DominicChm/eCVT/..Miscellaneous/Finite State Machine Diagrams.pptx

TASK 1
eCVT RATIO

PRIMARY
ENCODER
TICKS

SECONDARY
ENCODER
TICKS

TASK 2
PRIMARY CLUTCH

TASK 3
SECONDARY CLUTCH

## Slide 2

TASK 1
eCVT RATIO

PRIMARY
ENCODER
TICKS

SECONDARY
ENCODER
TICKS

TASK 2
PRIMARY CLUTCH

TASK 3
SECONDARY CLUTCH

TUNE DATA

TASK 4
Xbee Communication

STATS DATA

## Slide 3

ENGINE SPEED < 3000
-- OR -- eRUN IS FALSE

STATE 0
INITIALIZE

ALWAYS

ALWAYS /
eCAL IS FALSE

STATE 1
DISENGAGED

STATE 3
PID CONTROLLER
- UPDATE

STATE 2
PID CONTROLLER
- REST

ENGINE SPEED > 3000
-- AND -- eRUN IS TRUE

eCAL IS TRUE

## Slide 4

ALWAYS

STATE 0
INITIALIZE

STATE 1
CALIBRATING

ALWAYS /
pCAL IS FALSE

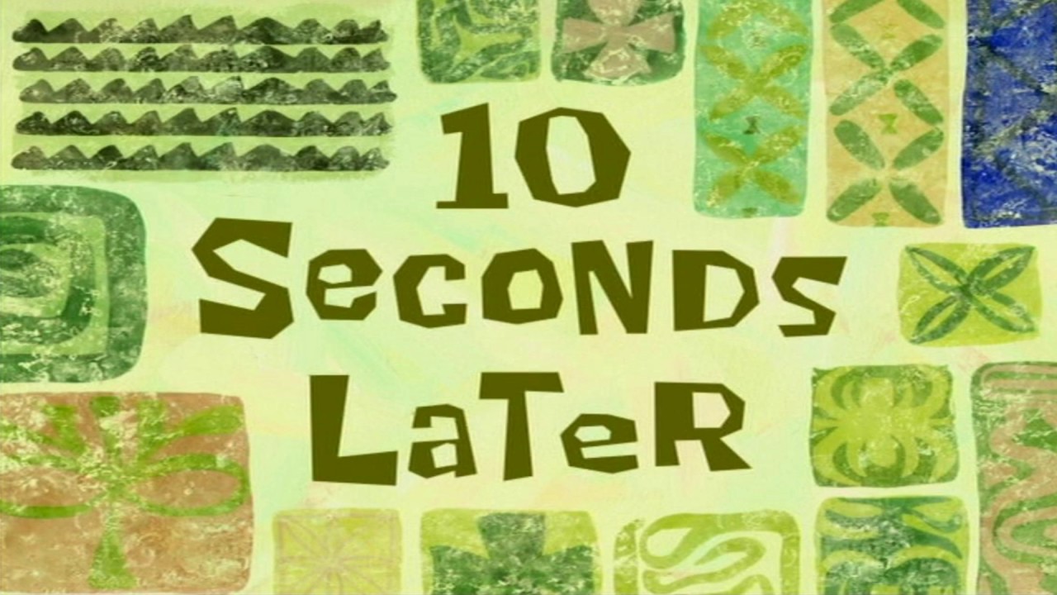
[picture p1: figure]

STATE 4
PID CONTROLLER
- UPDATE

STATE 2
CALIBRATED

STATE 3
PID CONTROLLER
- REST

pCAL IS TRUE

ALWAYS

## Slide 5

ALWAYS

STATE 0
INITIALIZE

STATE 1
CALIBRATING

ALWAYS /
sCAL IS FALSE

STATE 4
PID CONTROLLER
- UPDATE

STATE 2
CALIBRATED

STATE 3
PID CONTROLLER
- REST

sCAL IS TRUE

ALWAYS
