DominicChm/eCVT/..Miscellaneous/Simulation/PID Simulation/PID.pdf

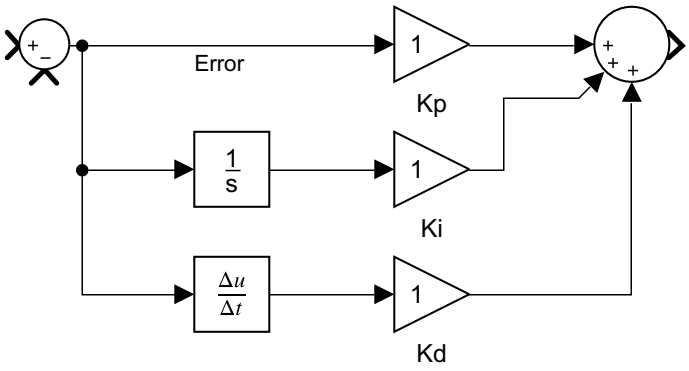
[picture p2: figure]
