DominicChm/eCVT/..Miscellaneous/Simulation/Lookup Table Simulation/CVT Ratio Lookup Table.png

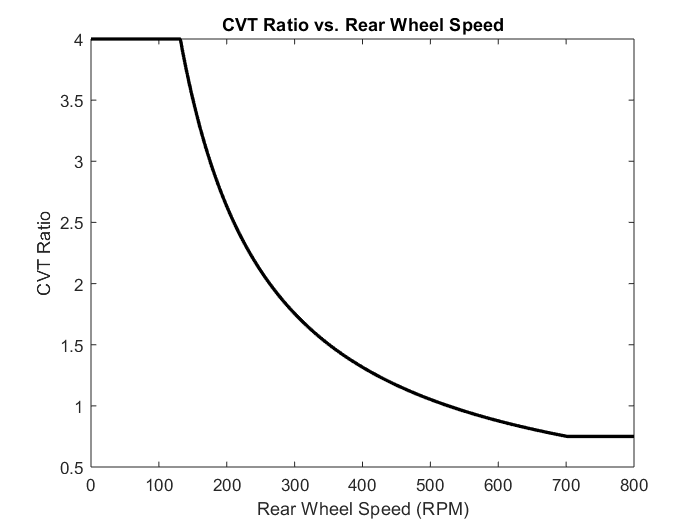
..Miscellaneous/Simulation/Lookup Table Simulation/CVT Ratio Lookup Table.png
