DominicChm/eCVT/..Miscellaneous/Simulation/PID Simulation/06-04-2019 PDR/Kp=0.002_Ki=0.010.png

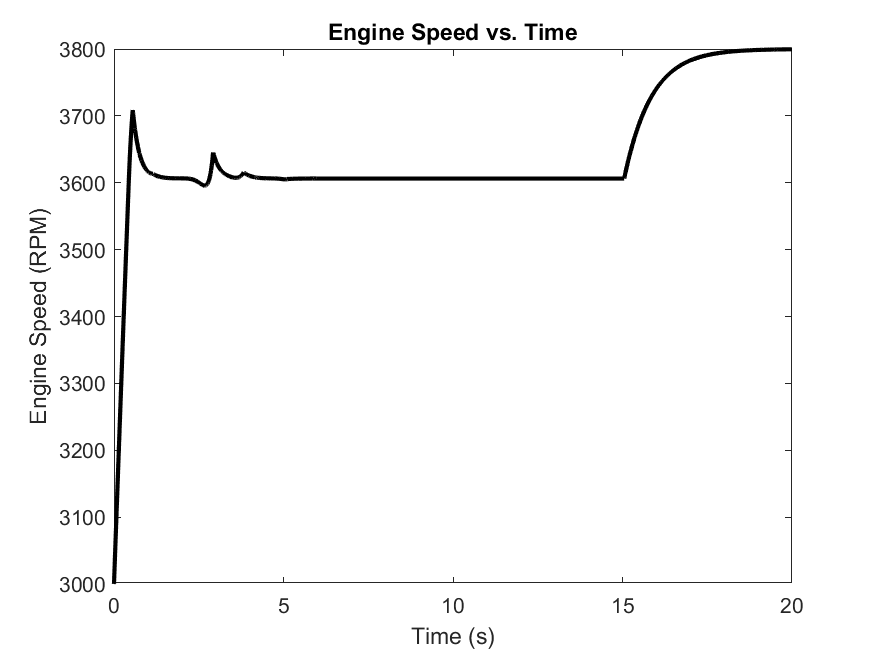
..Miscellaneous/Simulation/PID Simulation/06-04-2019 PDR/Kp=0.002_Ki=0.010.png
