DominicChm/eCVT/..Miscellaneous/Simulation/PID Simulation/06-04-2019 PDR/Kp=0.004_Ki=0.007.png

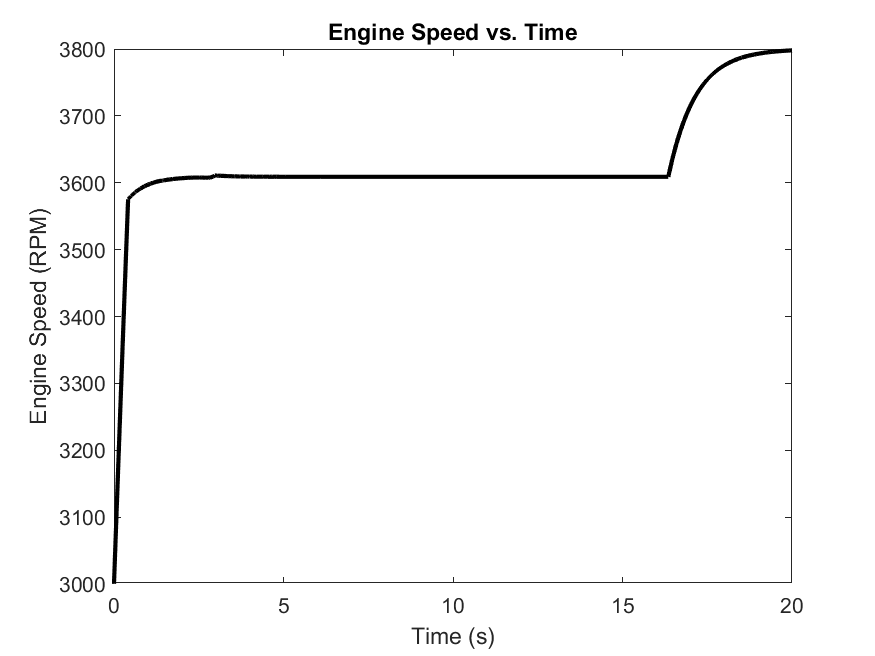
..Miscellaneous/Simulation/PID Simulation/06-04-2019 PDR/Kp=0.004_Ki=0.007.png
