DominicChm/eCVT/..Miscellaneous/Simulation/PID Simulation/EngineControl_PID_Complex.PNG

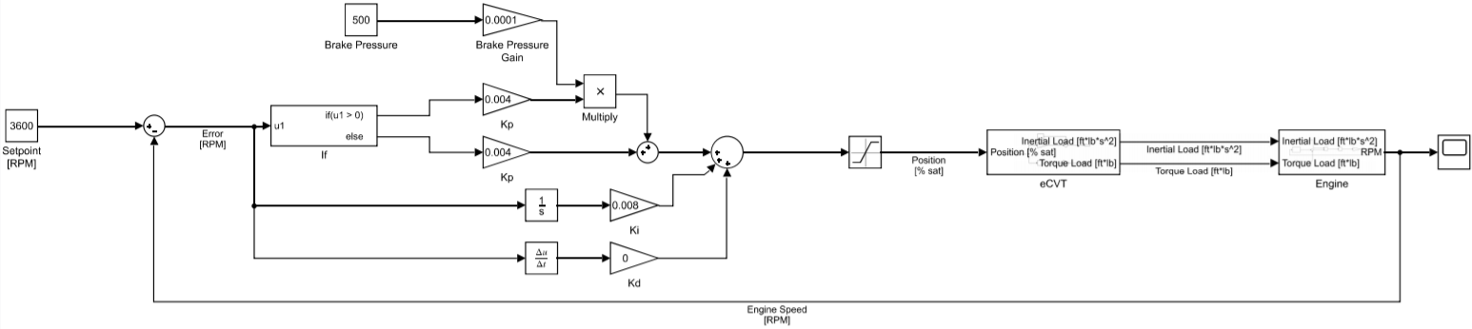
..Miscellaneous/Simulation/PID Simulation/EngineControl_PID_Complex.PNG
