DominicChm/eCVT/..Miscellaneous/Simulation/PID Simulation/EngineControl_PID_Complex_With_Sheaves.PNG

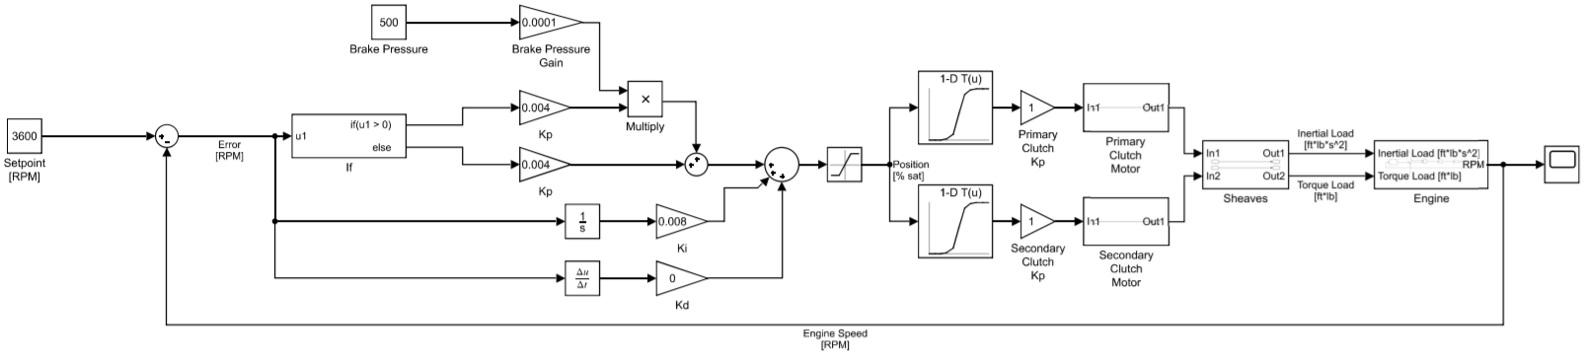
..Miscellaneous/Simulation/PID Simulation/EngineControl_PID_Complex_With_Sheaves.PNG
