DominicChm/eCVT/..Miscellaneous/Overview/ClutchControl_Overview.pdf

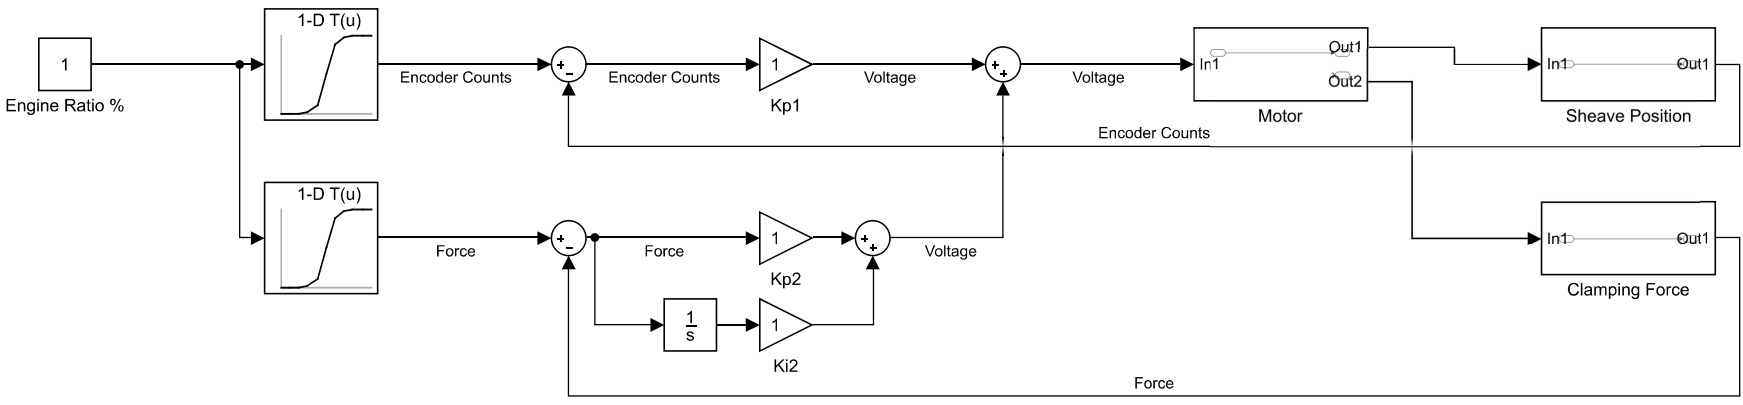
[picture p8: page 1]
