DominicChm/eCVT/..Miscellaneous/Simulation/PID Simulation/EngineControl_PID_Complex_With_Sheaves.pdf

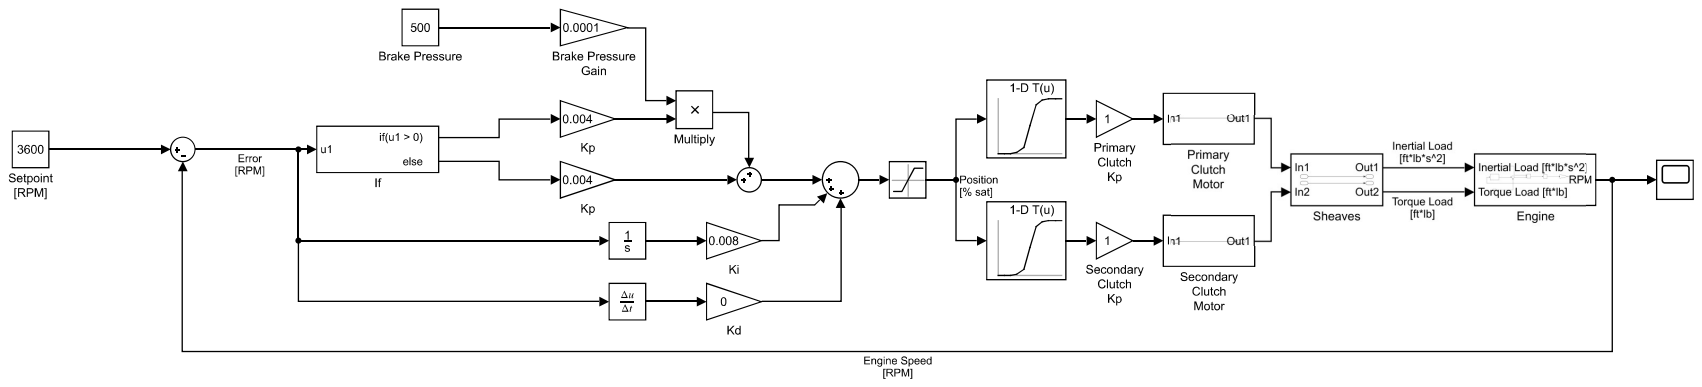
[picture p13: page 1]
