DominicChm/eCVT/..Miscellaneous/Simulation/PID Simulation/EngineControl_PID_Complex.pdf

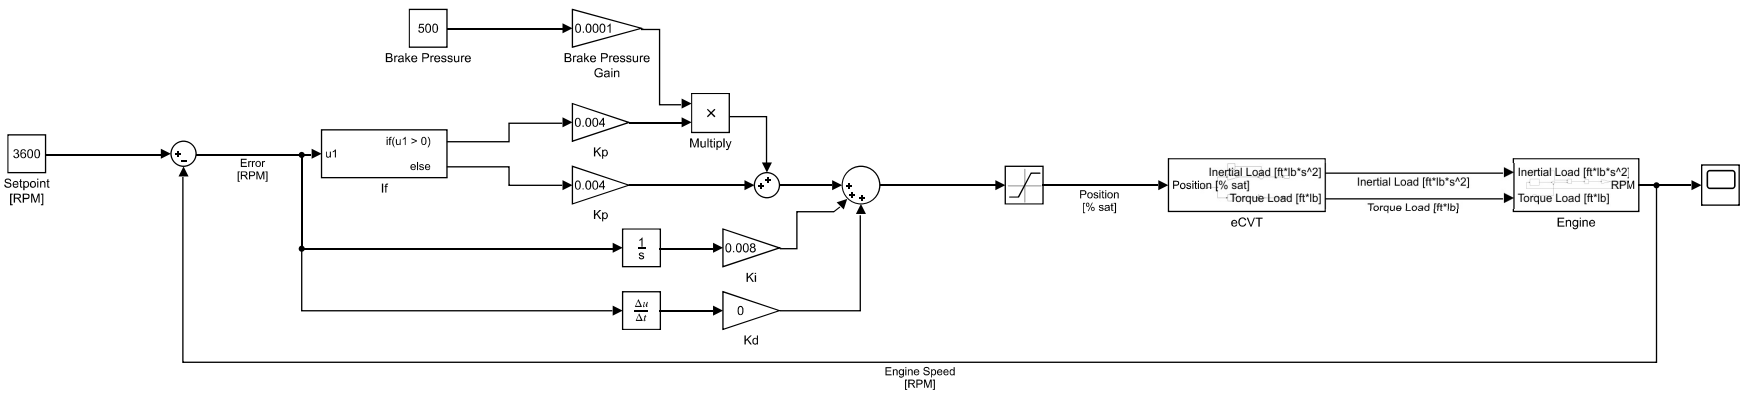
[picture p14: page 1]
