DominicChm/eCVT/..Miscellaneous/Hardware/March 2020 Edition/EAGLE/projects/DAQ and eCVT/DAQ and eCVT.brd

## EAGLE design ..Miscellaneous/Hardware/March 2020 Edition/EAGLE/projects/DAQ and eCVT/DAQ and eCVT.brd (2020-03-10)

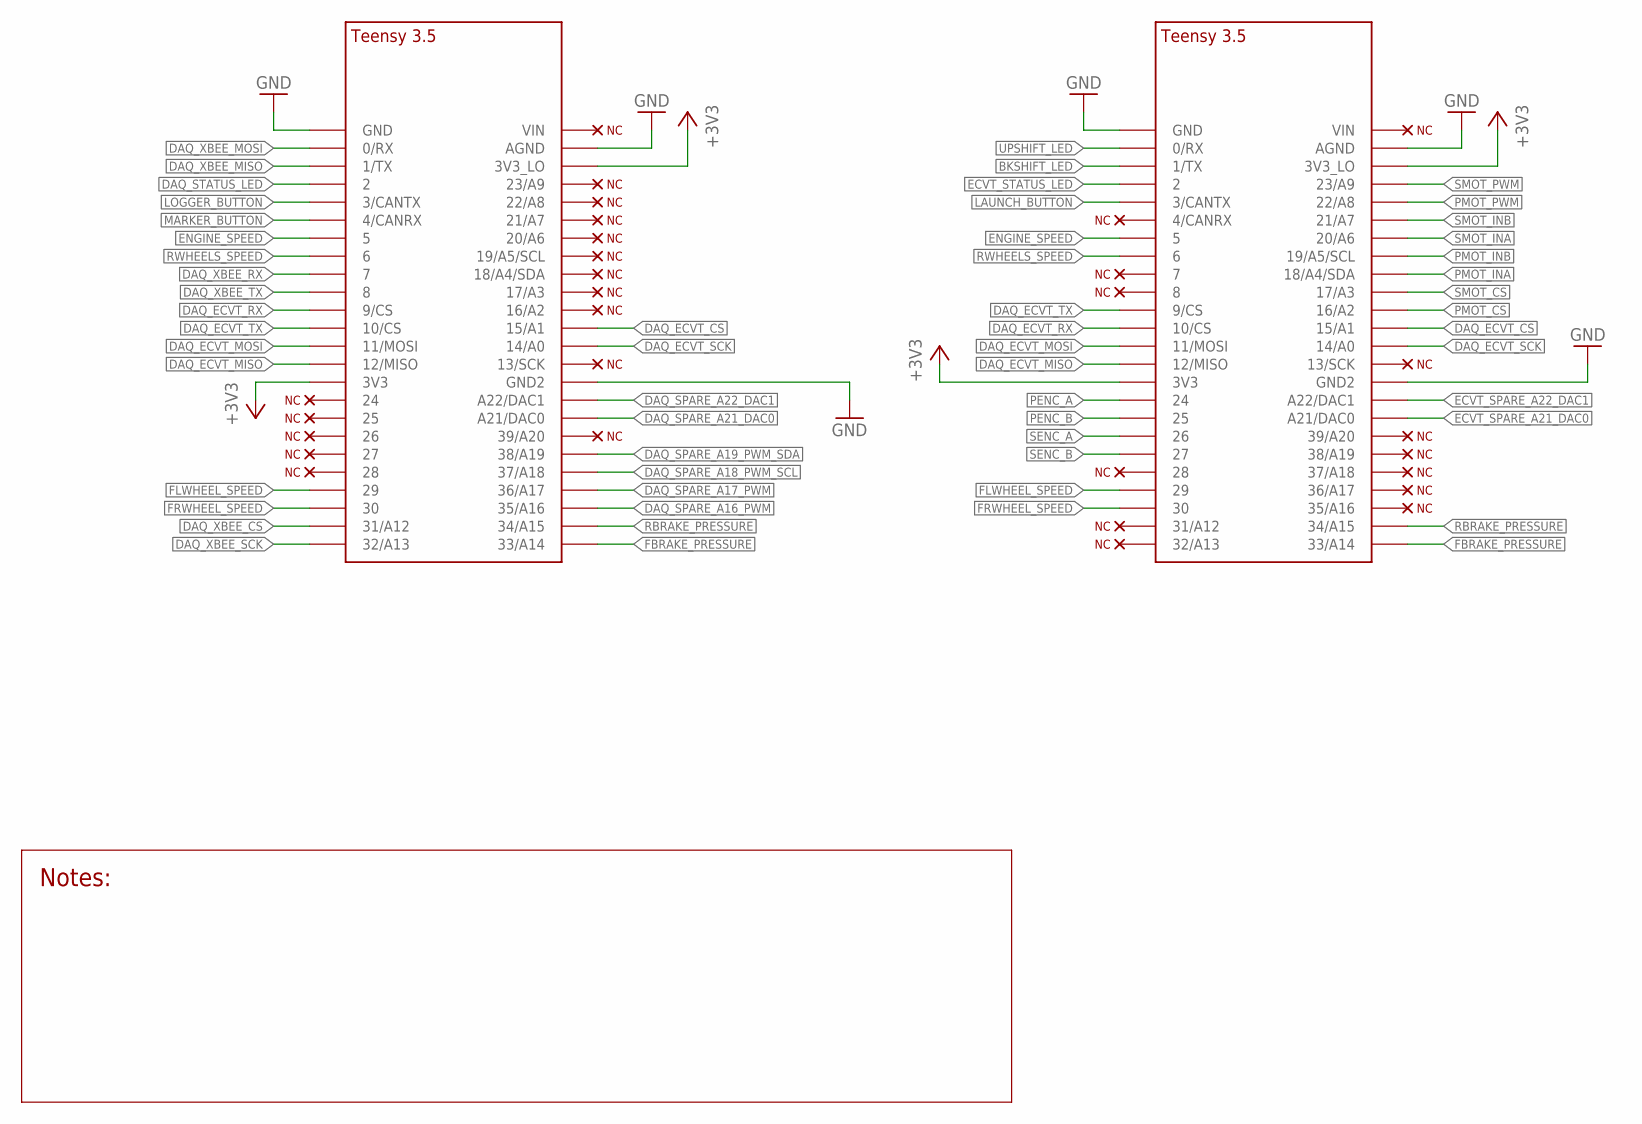
[picture p15: schematic DAQ and eCVT.sch, sheet 1]

Parts:
U$31, U$33: TEENSY_3.5_BAJA

Connections:
+3V3: U$31.3V3, U$31.3V3_LO, U$33.3V3, U$33.3V3_LO; also elsewhere on the board
BKSHIFT_LED: U$33.1/TX; also elsewhere on the board
DAQ_ECVT_CS: U$31.15/A1, U$33.15/A1
DAQ_ECVT_MISO: U$31.12/MISO, U$33.12/MISO
DAQ_ECVT_MOSI: U$31.11/MOSI, U$33.11/MOSI
DAQ_ECVT_RX: U$31.9/CS, U$33.10/CS
DAQ_ECVT_SCK: U$31.14/A0, U$33.14/A0
DAQ_ECVT_TX: U$31.10/CS, U$33.9/CS
DAQ_SPARE_A16_PWM: U$31.35/A16; also elsewhere on the board
DAQ_SPARE_A17_PWM: U$31.36/A17; also elsewhere on the board
DAQ_SPARE_A18_PWM_SCL: U$31.37/A18; also elsewhere on the board
DAQ_SPARE_A19_PWM_SDA: U$31.38/A19; also elsewhere on the board
DAQ_SPARE_A21_DAC0: U$31.21/DAC0 (A21/DAC0); also elsewhere on the board
DAQ_SPARE_A22_DAC1: U$31.A22/DAC1; also elsewhere on the board
DAQ_STATUS_LED: U$31.2; also elsewhere on the board
DAQ_XBEE_CS: U$31.31/A12; also elsewhere on the board
DAQ_XBEE_MISO: U$31.1/TX; also elsewhere on the board
DAQ_XBEE_MOSI: U$31.0/RX; also elsewhere on the board
DAQ_XBEE_RX: U$31.7; also elsewhere on the board
DAQ_XBEE_SCK: U$31.32/A13; also elsewhere on the board
DAQ_XBEE_TX: U$31.8; also elsewhere on the board
ECVT_SPARE_A21_DAC0: U$33.21/DAC0 (A21/DAC0); also elsewhere on the board
ECVT_SPARE_A22_DAC1: U$33.A22/DAC1; also elsewhere on the board
ECVT_STATUS_LED: U$33.2; also elsewhere on the board
ENGINE_SPEED: U$31.5, U$33.5; also elsewhere on the board
FBRAKE_PRESSURE: U$31.33/A14, U$33.33/A14; also elsewhere on the board
FLWHEEL_SPEED: U$31.29, U$33.29; also elsewhere on the board
FRWHEEL_SPEED: U$31.30, U$33.30; also elsewhere on the board
GND: U$31.AGND, U$31.GND, U$31.GND2, U$33.AGND, U$33.GND, U$33.GND2; also elsewhere on the board
LAUNCH_BUTTON: U$33.3/CANTX; also elsewhere on the board
LOGGER_BUTTON: U$31.3/CANTX; also elsewhere on the board
MARKER_BUTTON: U$31.4/CANRX; also elsewhere on the board
PENC_A: U$33.24; also elsewhere on the board
PENC_B: U$33.25; also elsewhere on the board
PMOT_CS: U$33.16/A2; also elsewhere on the board
PMOT_INA: U$33.18/A4/SDA; also elsewhere on the board
PMOT_INB: U$33.19/A5/SCL; also elsewhere on the board
PMOT_PWM: U$33.22/A8; also elsewhere on the board
RBRAKE_PRESSURE: U$31.34/A15, U$33.34/A15; also elsewhere on the board
RWHEELS_SPEED: U$31.6, U$33.6; also elsewhere on the board
SENC_A: U$33.26; also elsewhere on the board
SENC_B: U$33.27; also elsewhere on the board
SMOT_CS: U$33.17/A3; also elsewhere on the board
SMOT_INA: U$33.20/A6; also elsewhere on the board
SMOT_INB: U$33.21/A7; also elsewhere on the board
SMOT_PWM: U$33.23/A9; also elsewhere on the board
UPSHIFT_LED: U$33.0/RX; also elsewhere on the board

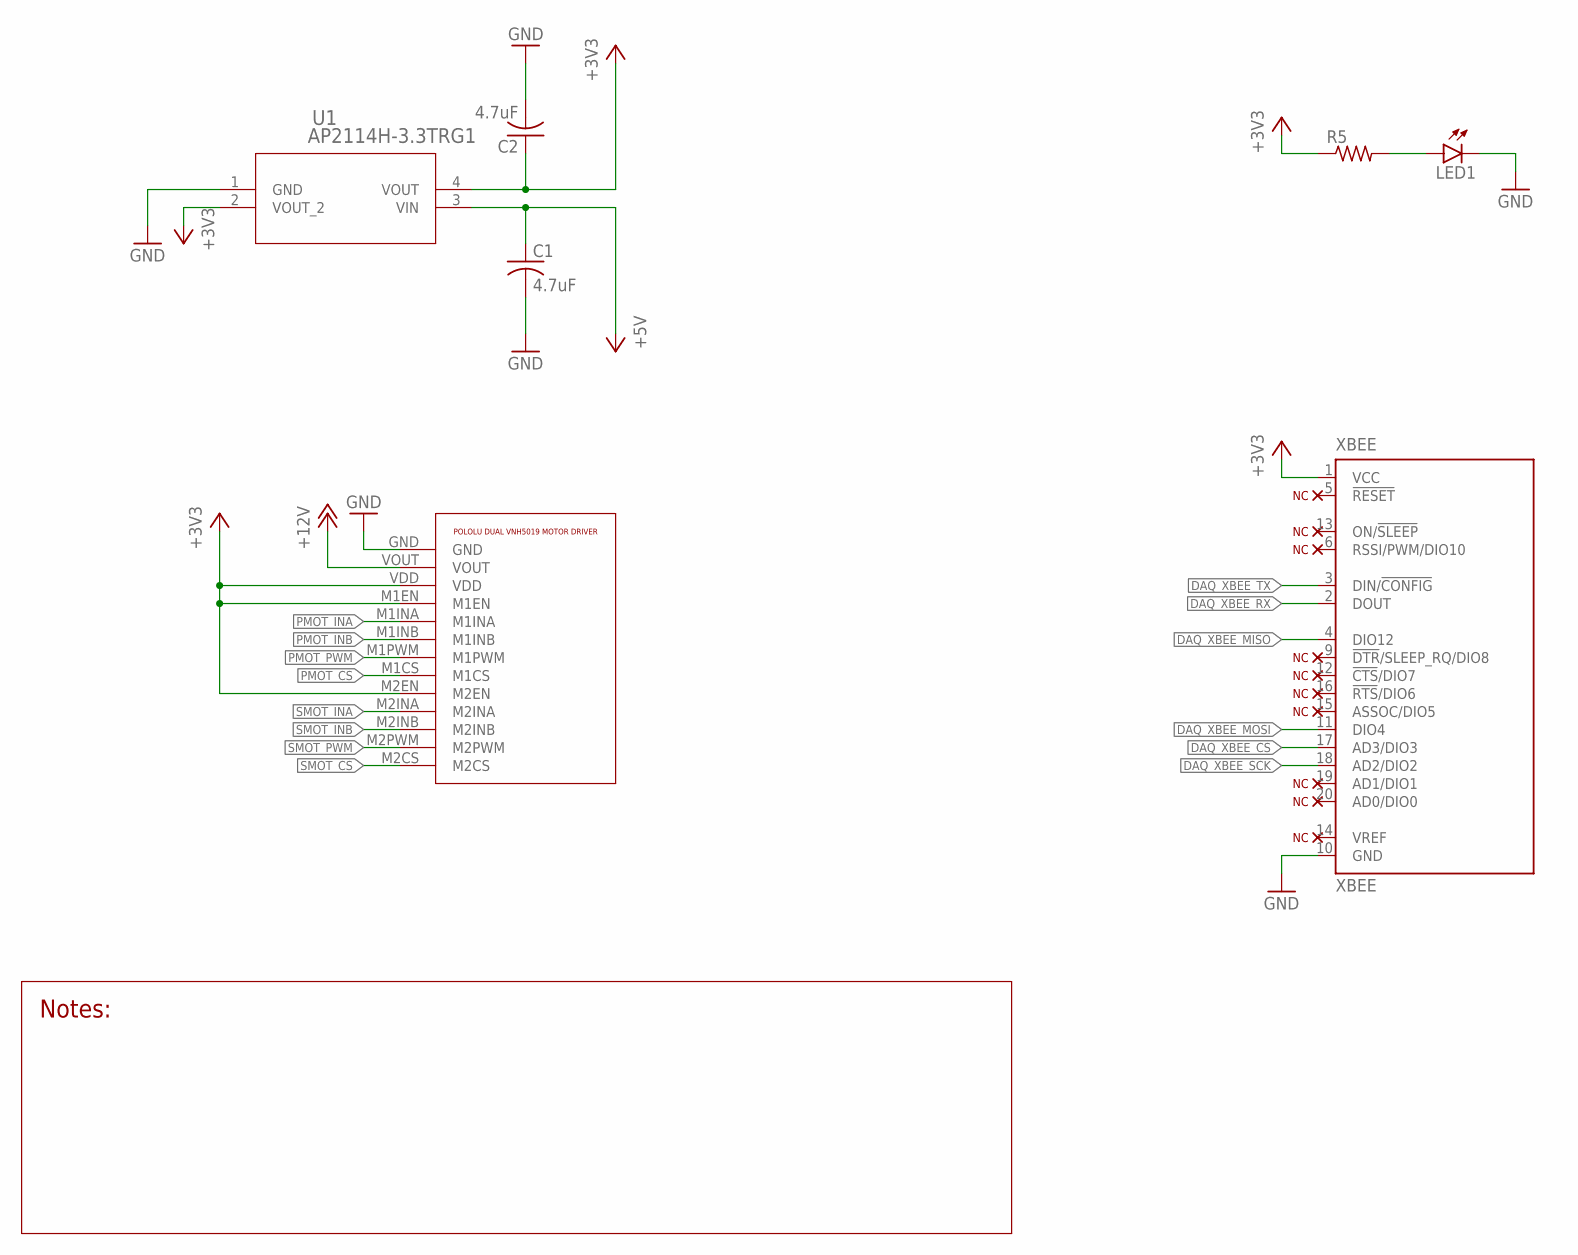
[picture p16: schematic DAQ and eCVT.sch, sheet 2]

Parts:
C1, C2: 4.7uF; C0805
LED1: LEDCHIPLED_0805; CHIPLED_0805
R5: R-US_R0805; R0805
U1: AP2114H-3.3TRG1; SOT-223
U$28: POLOLU_DUAL_VNH5019_BAJA
XBEE: XBEE

Connections:
+3V3: C2.1, R5.1, U1.2 (VOUT_2), U1.4 (VOUT), U$28.M1EN, U$28.M2EN, U$28.VDD, XBEE.1 (VCC); also elsewhere on the board
+5V: C1.1, U1.3 (VIN); also elsewhere on the board
+12V: U$28.VOUT; also elsewhere on the board
DAQ_XBEE_CS: XBEE.17 (AD3/DIO3); also elsewhere on the board
DAQ_XBEE_MISO: XBEE.4 (DIO12); also elsewhere on the board
DAQ_XBEE_MOSI: XBEE.11 (DIO4); also elsewhere on the board
DAQ_XBEE_RX: XBEE.2 (DOUT); also elsewhere on the board
DAQ_XBEE_SCK: XBEE.18 (AD2/DIO2); also elsewhere on the board
DAQ_XBEE_TX: XBEE.3 (DIN/!CONFIG); also elsewhere on the board
GND: C1.2, C2.2, LED1.C, U1.1 (GND), U$28.GND, XBEE.10 (GND); also elsewhere on the board
LED: LED1.A, R5.2
PMOT_CS: U$28.M1CS; also elsewhere on the board
PMOT_INA: U$28.M1INA; also elsewhere on the board
PMOT_INB: U$28.M1INB; also elsewhere on the board
PMOT_PWM: U$28.M1PWM; also elsewhere on the board
SMOT_CS: U$28.M2CS; also elsewhere on the board
SMOT_INA: U$28.M2INA; also elsewhere on the board
SMOT_INB: U$28.M2INB; also elsewhere on the board
SMOT_PWM: U$28.M2PWM; also elsewhere on the board

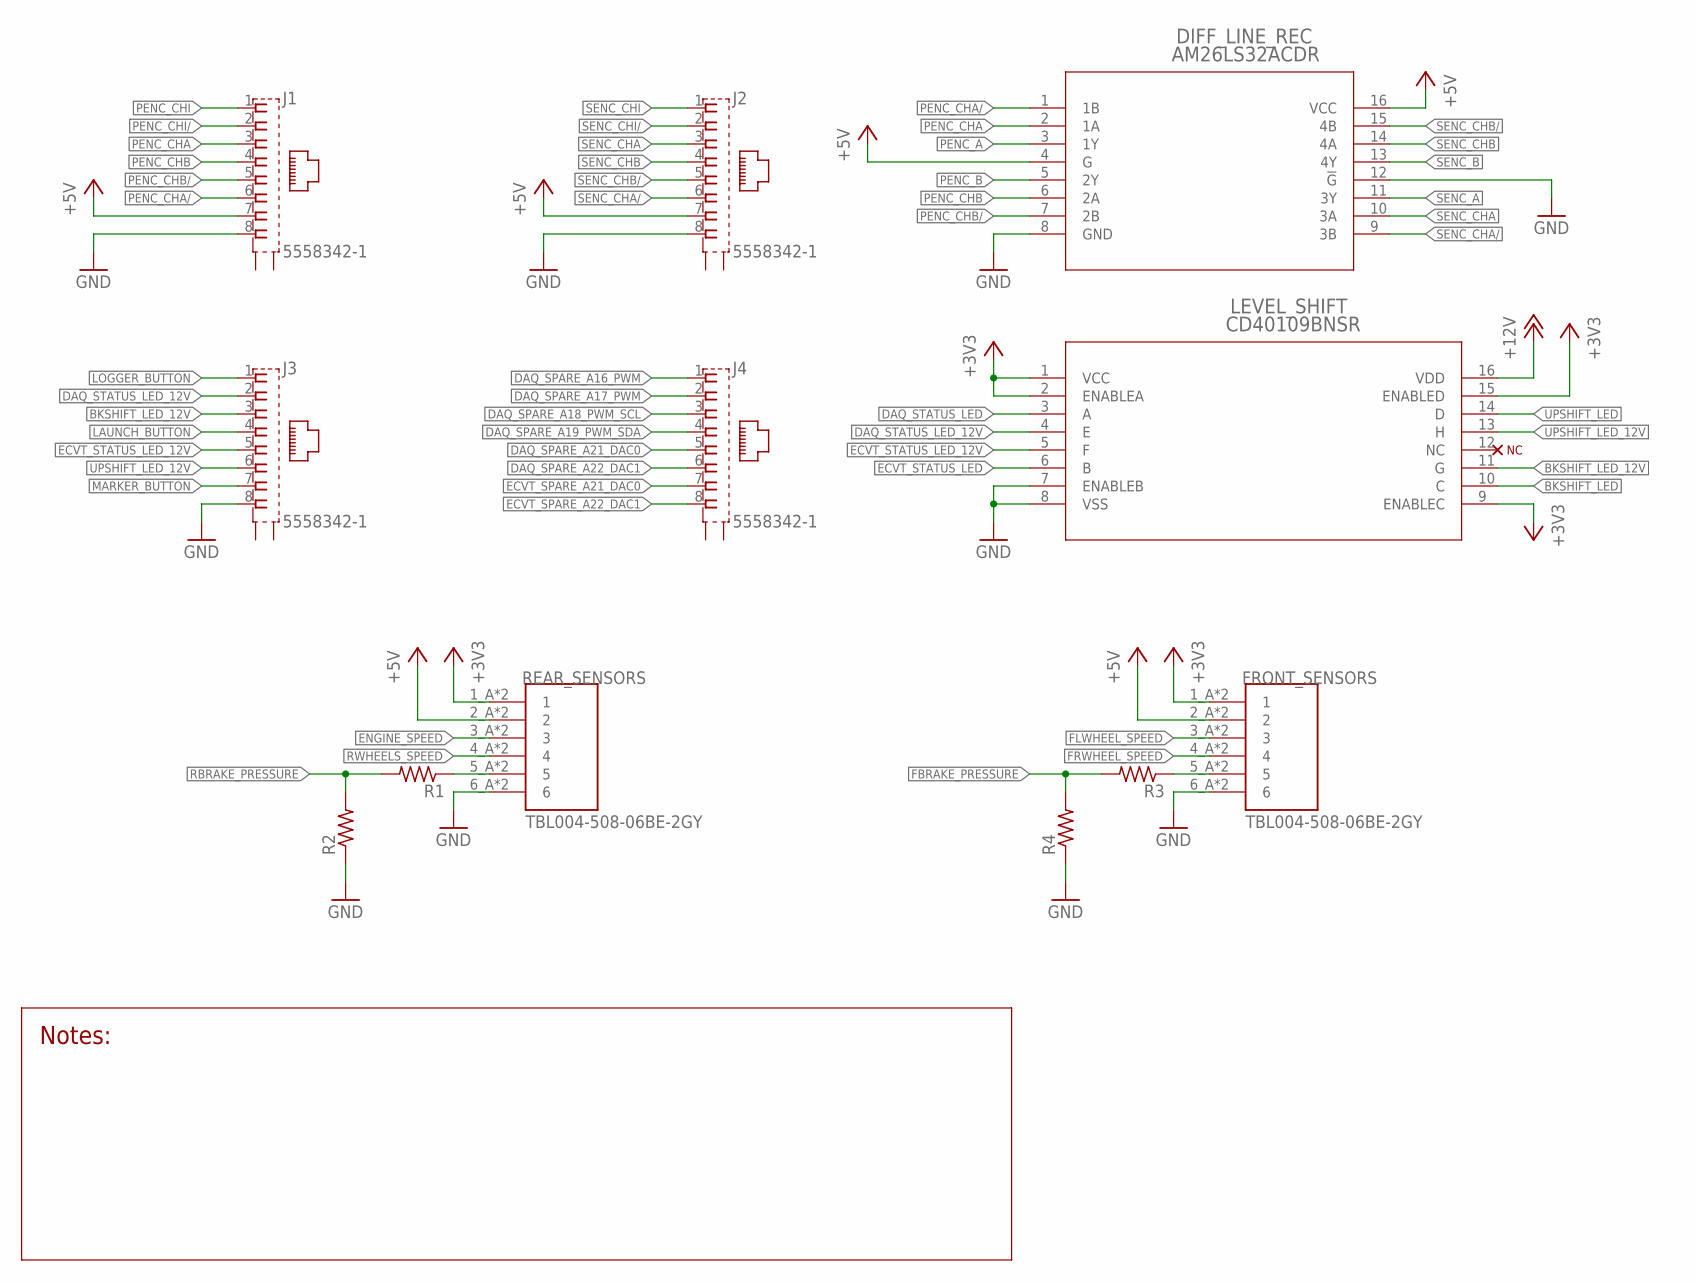
[picture p17: schematic DAQ and eCVT.sch, sheet 3]

Parts:
DIFF_LINE_REC: AM26LS32ACDR; D16
FRONT_SENSORS: TBL004-508-06BE-2GY; CUI_TBL004-508-06BE-2GY
J1, J2, J3, J4: 5558342-1; TE_5558342-1
LEVEL_SHIFT: CD40109BNSR; NS16
R1, R2, R3, R4: R-US_0204/7; 0204/7
REAR_SENSORS: TBL004-508-06BE-2GY; CUI_TBL004-508-06BE-2GY

Connections:
+3V3: FRONT_SENSORS.1_A (1), FRONT_SENSORS.1_B (1), LEVEL_SHIFT.1 (VCC), LEVEL_SHIFT.2 (ENABLEA), LEVEL_SHIFT.9 (ENABLEC), LEVEL_SHIFT.15 (ENABLED), REAR_SENSORS.1_A (1), REAR_SENSORS.1_B (1); also elsewhere on the board
+5V: DIFF_LINE_REC.4 (G), DIFF_LINE_REC.16 (VCC), FRONT_SENSORS.2_A (2), FRONT_SENSORS.2_B (2), J1.7, J2.7, REAR_SENSORS.2_A (2), REAR_SENSORS.2_B (2); also elsewhere on the board
+12V: LEVEL_SHIFT.16 (VDD); also elsewhere on the board
BKSHIFT_LED: LEVEL_SHIFT.10 (C); also elsewhere on the board
BKSHIFT_LED_12V: J3.3, LEVEL_SHIFT.11 (G)
DAQ_SPARE_A16_PWM: J4.1; also elsewhere on the board
DAQ_SPARE_A17_PWM: J4.2; also elsewhere on the board
DAQ_SPARE_A18_PWM_SCL: J4.3; also elsewhere on the board
DAQ_SPARE_A19_PWM_SDA: J4.4; also elsewhere on the board
DAQ_SPARE_A21_DAC0: J4.5; also elsewhere on the board
DAQ_SPARE_A22_DAC1: J4.6; also elsewhere on the board
DAQ_STATUS_LED: LEVEL_SHIFT.3 (A); also elsewhere on the board
DAQ_STATUS_LED_12V: J3.2, LEVEL_SHIFT.4 (E)
ECVT_SPARE_A21_DAC0: J4.7; also elsewhere on the board
ECVT_SPARE_A22_DAC1: J4.8; also elsewhere on the board
ECVT_STATUS_LED: LEVEL_SHIFT.6 (B); also elsewhere on the board
ECVT_STATUS_LED_12V: J3.5, LEVEL_SHIFT.5 (F)
ENGINE_SPEED: REAR_SENSORS.3_A (3), REAR_SENSORS.3_B (3); also elsewhere on the board
FBRAKE_PRESSURE: R3.2, R4.2; also elsewhere on the board
FBRAKE_PRESSURE_BEFORE_RESISTORS: FRONT_SENSORS.5_A (5), FRONT_SENSORS.5_B (5), R3.1
FLWHEEL_SPEED: FRONT_SENSORS.3_A (3), FRONT_SENSORS.3_B (3); also elsewhere on the board
FRWHEEL_SPEED: FRONT_SENSORS.4_A (4), FRONT_SENSORS.4_B (4); also elsewhere on the board
GND: DIFF_LINE_REC.8 (GND), DIFF_LINE_REC.12 (!G), FRONT_SENSORS.6_A (6), FRONT_SENSORS.6_B (6), J1.8, J2.8, J3.8, LEVEL_SHIFT.7 (ENABLEB), LEVEL_SHIFT.8 (VSS), R2.1, R4.1, REAR_SENSORS.6_A (6), REAR_SENSORS.6_B (6); also elsewhere on the board
LAUNCH_BUTTON: J3.4; also elsewhere on the board
LOGGER_BUTTON: J3.1; also elsewhere on the board
MARKER_BUTTON: J3.7; also elsewhere on the board
PENC_A: DIFF_LINE_REC.3 (1Y); also elsewhere on the board
PENC_B: DIFF_LINE_REC.5 (2Y); also elsewhere on the board
PENC_CHA: DIFF_LINE_REC.2 (1A), J1.3
PENC_CHA/: DIFF_LINE_REC.1 (1B), J1.6
PENC_CHB: DIFF_LINE_REC.6 (2A), J1.4
PENC_CHB/: DIFF_LINE_REC.7 (2B), J1.5
PENC_CHI: J1.1
PENC_CHI/: J1.2
RBRAKE_PRESSURE: R1.2, R2.2; also elsewhere on the board
RBRAKE_PRESSURE_BEFORE_RESISTORS: R1.1, REAR_SENSORS.5_A (5), REAR_SENSORS.5_B (5)
RWHEELS_SPEED: REAR_SENSORS.4_A (4), REAR_SENSORS.4_B (4); also elsewhere on the board
SENC_A: DIFF_LINE_REC.11 (3Y); also elsewhere on the board
SENC_B: DIFF_LINE_REC.13 (4Y); also elsewhere on the board
SENC_CHA: DIFF_LINE_REC.10 (3A), J2.3
SENC_CHA/: DIFF_LINE_REC.9 (3B), J2.6
SENC_CHB: DIFF_LINE_REC.14 (4A), J2.4
SENC_CHB/: DIFF_LINE_REC.15 (4B), J2.5
SENC_CHI: J2.1
SENC_CHI/: J2.2
UPSHIFT_LED: LEVEL_SHIFT.14 (D); also elsewhere on the board
UPSHIFT_LED_12V: J3.6, LEVEL_SHIFT.13 (H)

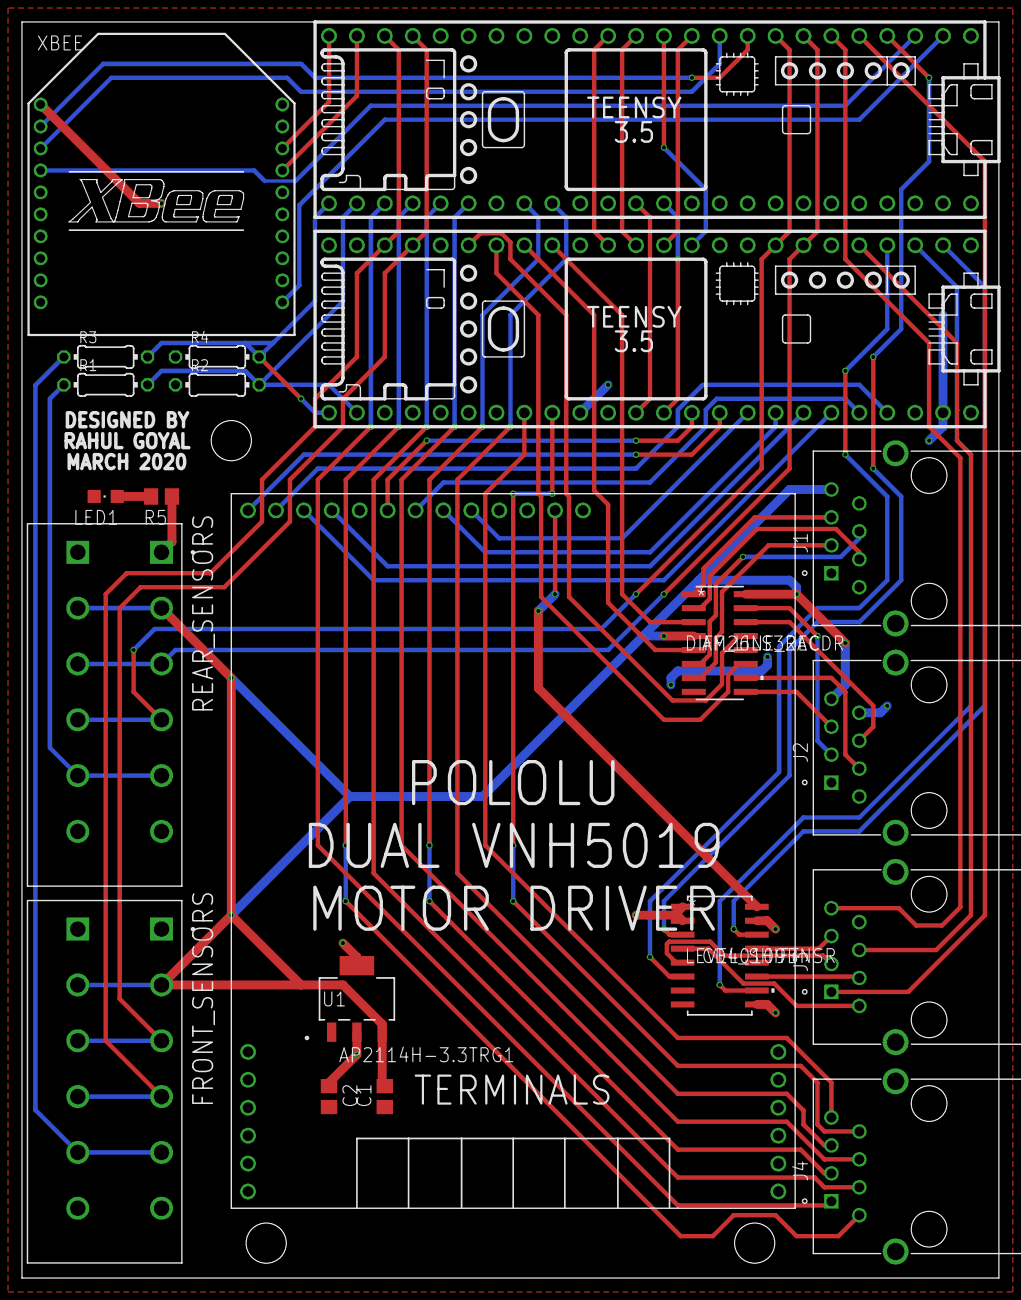
[picture p18: board ..Miscellaneous/Hardware/March 2020 Edition/EAGLE/projects/DAQ and eC… from above]

Board: 2 copper layers, 88.9 x 114.3 mm, 21 parts (0 on the bottom side), 64 nets.
