DominicChm/eCVT/..Miscellaneous/Hardware/ME 507/EAGLE/projects/eCVT 507/eCVT 507.brd

## EAGLE design ..Miscellaneous/Hardware/ME 507/EAGLE/projects/eCVT 507/eCVT 507.brd (2019-12-09)

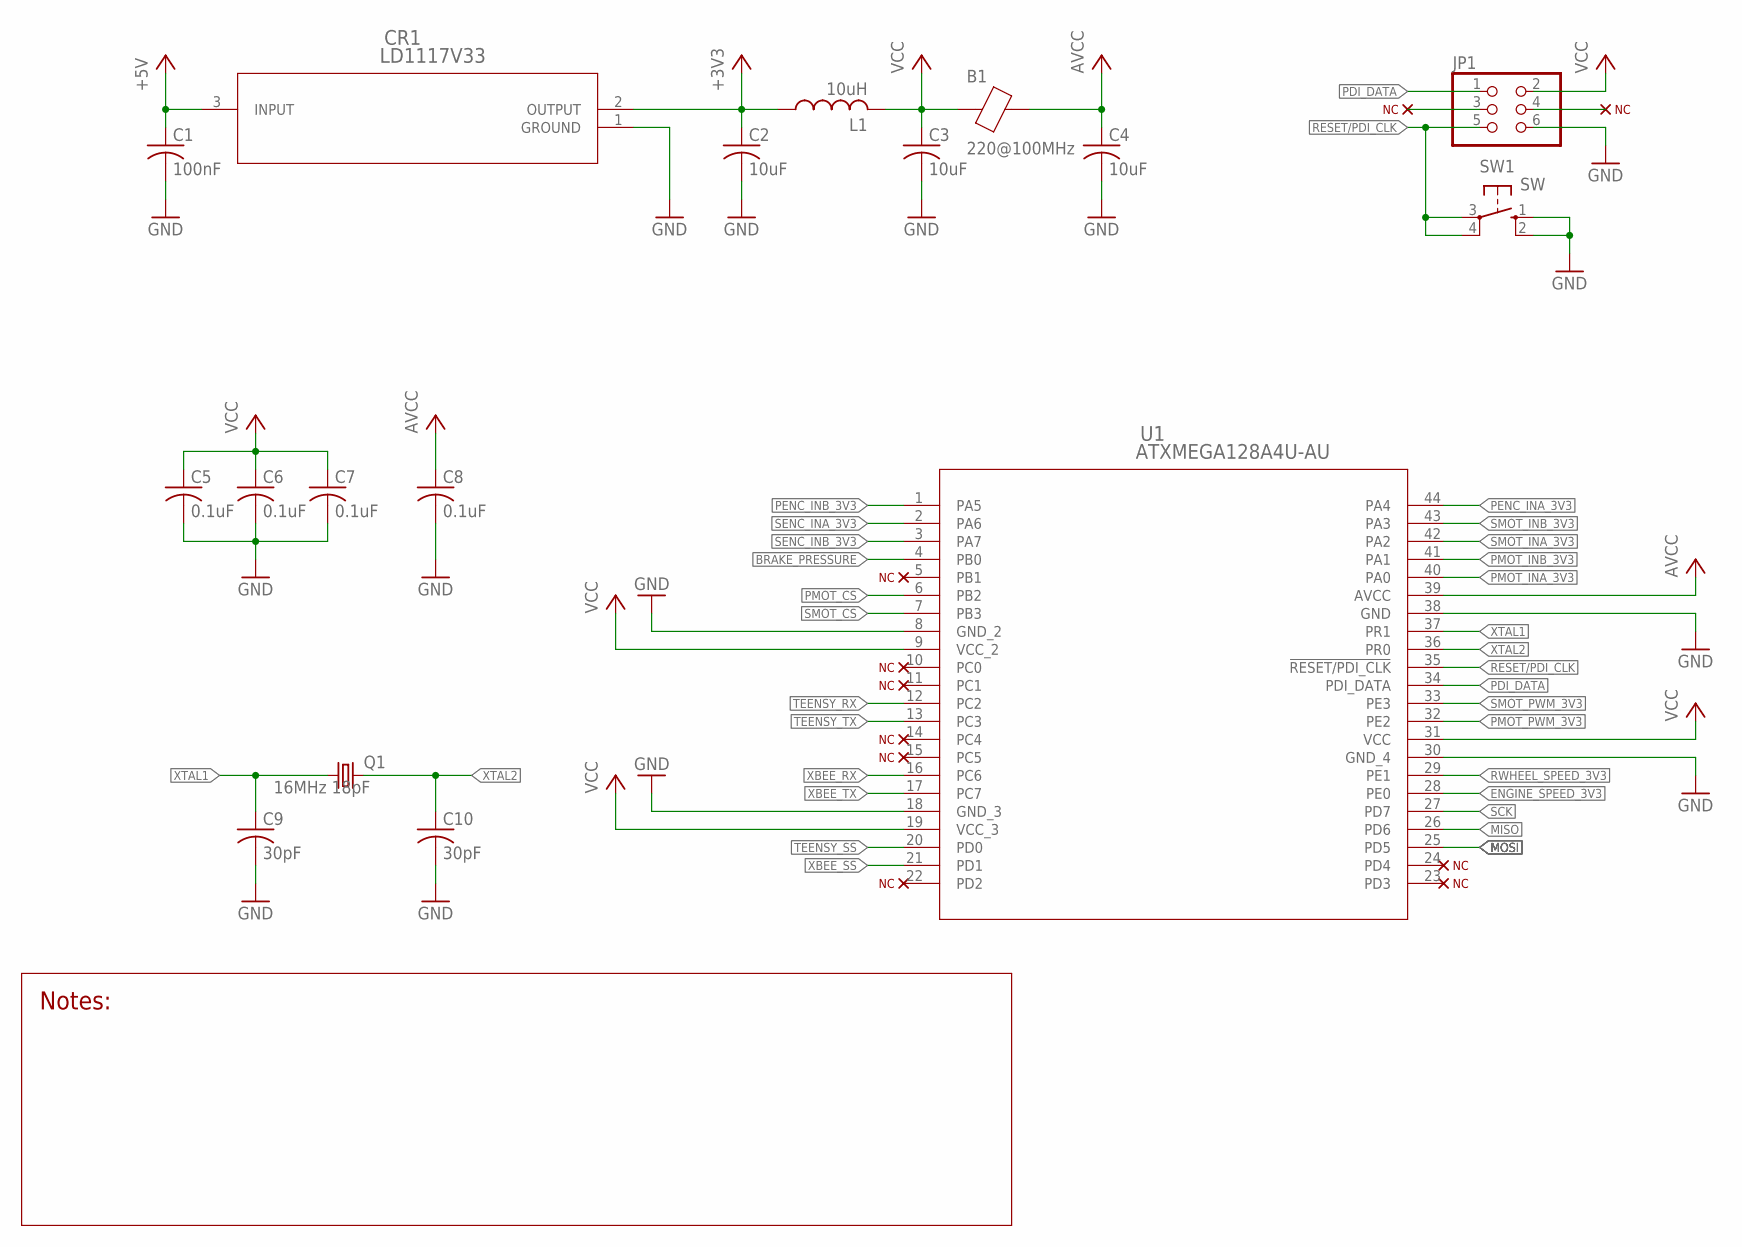
[picture p19: schematic eCVT 507.sch, sheet 1]

Parts:
B1: 220@100MHz; 0805
C1: 100nF; C0805
C2, C3, C4: 10uF; C0805
C5, C6, C7, C8: 0.1uF; C0805
C9, C10: 30pF; C0805
CR1: LD1117V33; TO-220
JP1: PINHD-2X3; 2X03
L1: 10uH; 0805
Q1: 16MHz 18pF; HC49/S
SW1: SW; B3F-10XX
U1: ATXMEGA128A4U-AU; 44A

Connections:
+3V3: C2.1, CR1.2 (OUTPUT), L1.1; also elsewhere on the board
+5V: C1.1, CR1.3 (INPUT); also elsewhere on the board
AVCC: B1.2, C4.1, C8.1, U1.39 (AVCC)
BRAKE_PRESSURE: U1.4 (PB0); also elsewhere on the board
ENGINE_SPEED_3V3: U1.28 (PE0); also elsewhere on the board
GND: C1.2, C2.2, C3.2, C4.2, C5.2, C6.2, C7.2, C8.2, C9.2, C10.2, CR1.1 (GROUND), JP1.6, SW1.1 (S), SW1.2 (S1), U1.8 (GND_2), U1.18 (GND_3), U1.30 (GND_4), U1.38 (GND); also elsewhere on the board
MISO: U1.26 (PD6); also elsewhere on the board
MOSI: U1.25 (PD5); also elsewhere on the board
PDI_DATA: JP1.1, U1.34 (PDI_DATA)
PENC_INA_3V3: U1.44 (PA4); also elsewhere on the board
PENC_INB_3V3: U1.1 (PA5); also elsewhere on the board
PMOT_CS: U1.6 (PB2); also elsewhere on the board
PMOT_INA_3V3: U1.40 (PA0); also elsewhere on the board
PMOT_INB_3V3: U1.41 (PA1); also elsewhere on the board
PMOT_PWM_3V3: U1.32 (PE2); also elsewhere on the board
RESET/PDI_CLK: JP1.5, SW1.3, SW1.4 (P1), U1.35 (!RESET/PDI_CLK)
RWHEEL_SPEED_3V3: U1.29 (PE1); also elsewhere on the board
SCK: U1.27 (PD7); also elsewhere on the board
SENC_INA_3V3: U1.2 (PA6); also elsewhere on the board
SENC_INB_3V3: U1.3 (PA7); also elsewhere on the board
SMOT_CS: U1.7 (PB3); also elsewhere on the board
SMOT_INA_3V3: U1.42 (PA2); also elsewhere on the board
SMOT_INB_3V3: U1.43 (PA3); also elsewhere on the board
SMOT_PWM_3V3: U1.33 (PE3); also elsewhere on the board
TEENSY_RX: U1.12 (PC2); also elsewhere on the board
TEENSY_SS: U1.20 (PD0); also elsewhere on the board
TEENSY_TX: U1.13 (PC3); also elsewhere on the board
VCC: B1.1, C3.1, C5.1, C6.1, C7.1, JP1.2, L1.2, U1.9 (VCC_2), U1.19 (VCC_3), U1.31 (VCC); also elsewhere on the board
XBEE_RX: U1.16 (PC6); also elsewhere on the board
XBEE_SS: U1.21 (PD1); also elsewhere on the board
XBEE_TX: U1.17 (PC7); also elsewhere on the board
XTAL1: C9.1, Q1.1, U1.37 (PR1)
XTAL2: C10.1, Q1.2, U1.36 (PR0)

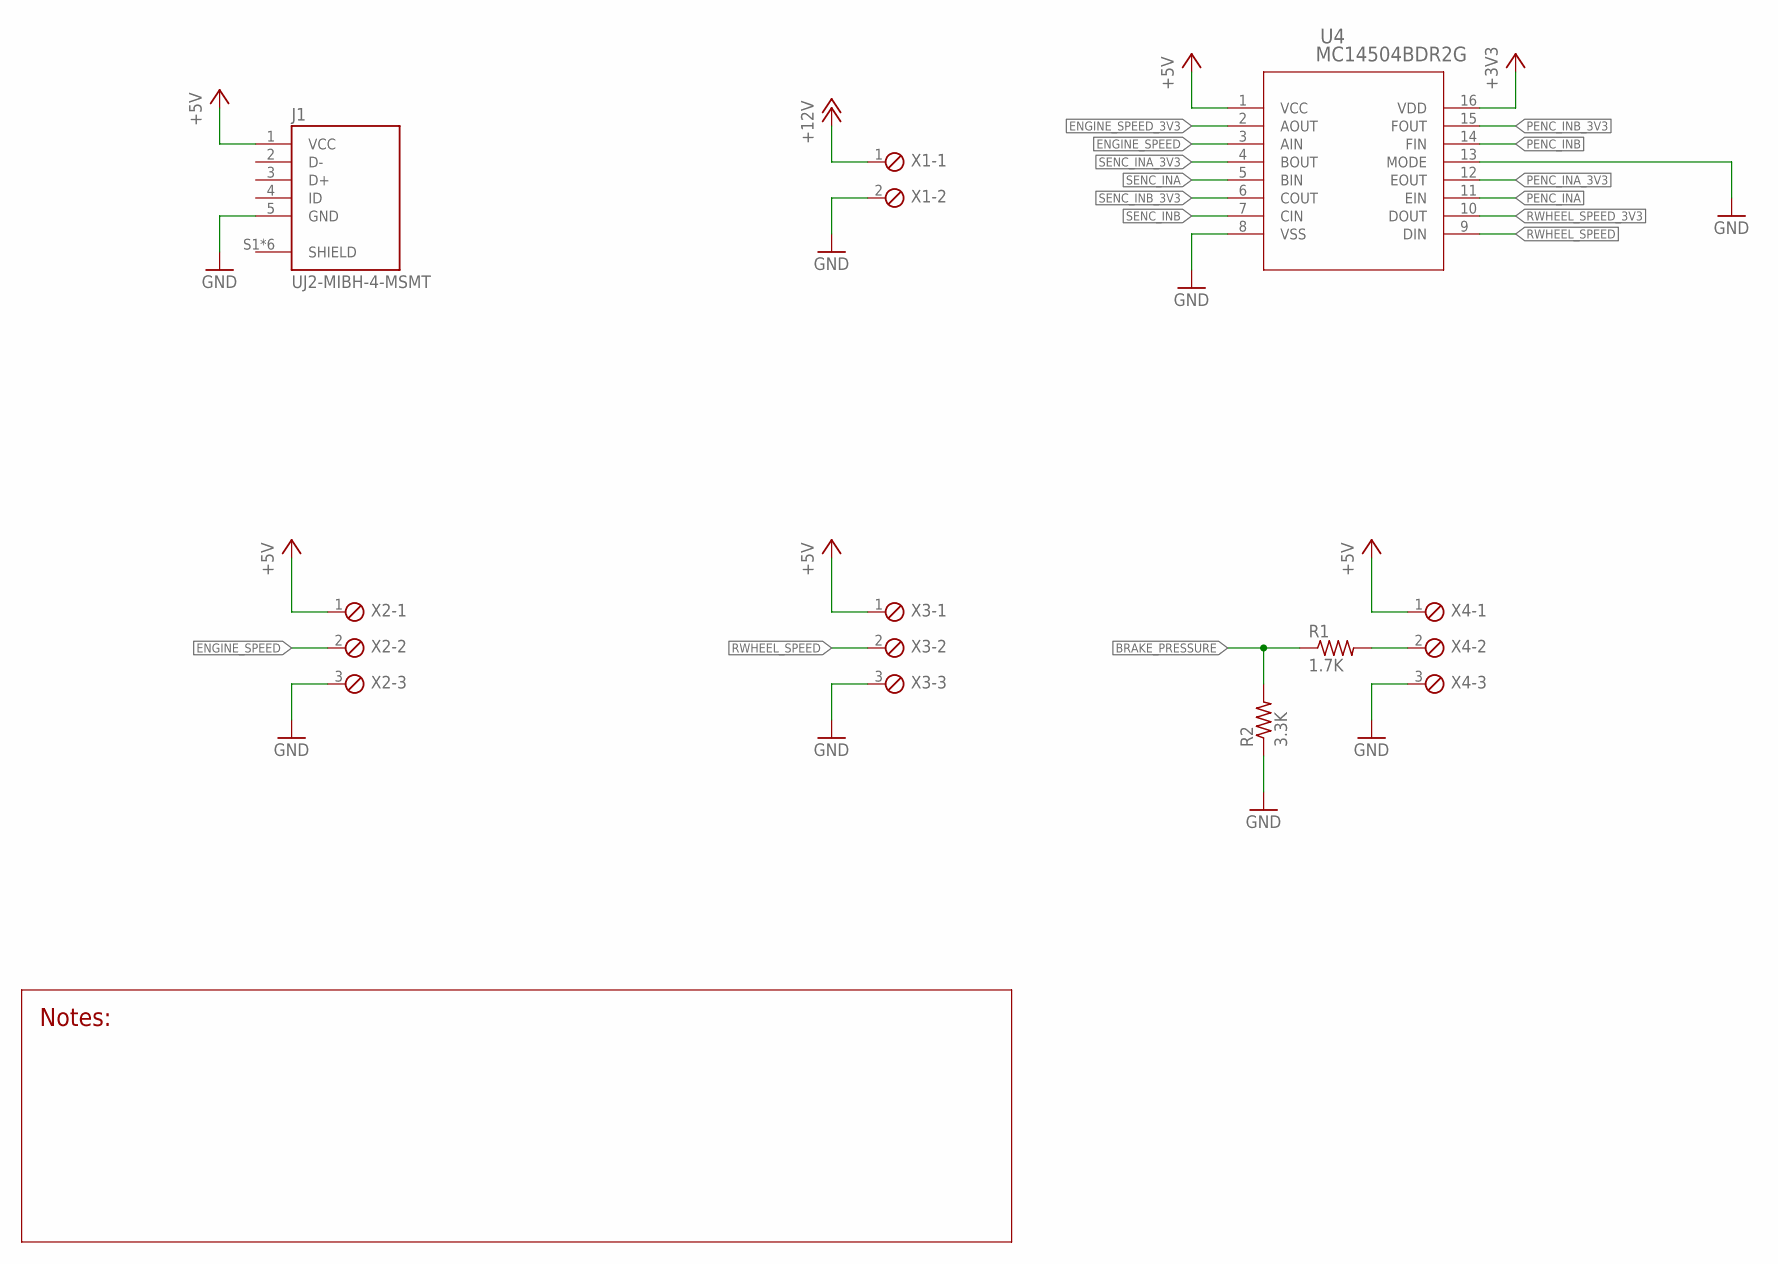
[picture p20: schematic eCVT 507.sch, sheet 2]

Parts:
J1: UJ2-MIBH-4-MSMT; CUI_UJ2-MIBH-4-MSMT
R1: 1.7K; R0805
R2: 3.3K; R0805
U4: MC14504BDR2G; SOIC-16
X1: SCREWTERM_2P_381; 2POL381
X2, X3, X4: SCREWTERM_3P_381; 3POL381

Connections:
+3V3: U4.16 (VDD); also elsewhere on the board
+5V: J1.1 (VCC), U4.1 (VCC), X2.1, X3.1, X4.1; also elsewhere on the board
+12V: X1.1; also elsewhere on the board
BRAKE_PRESSURE: R1.1, R2.2; also elsewhere on the board
ENGINE_SPEED: U4.3 (AIN), X2.2
ENGINE_SPEED_3V3: U4.2 (AOUT); also elsewhere on the board
GND: J1.5 (GND), R2.1, U4.8 (VSS), U4.13 (MODE), X1.2, X2.3, X3.3, X4.3; also elsewhere on the board
unnamed: R1.2, X4.2
PENC_INA: U4.11 (EIN); also elsewhere on the board
PENC_INA_3V3: U4.12 (EOUT); also elsewhere on the board
PENC_INB: U4.14 (FIN); also elsewhere on the board
PENC_INB_3V3: U4.15 (FOUT); also elsewhere on the board
RWHEEL_SPEED: U4.9 (DIN), X3.2
RWHEEL_SPEED_3V3: U4.10 (DOUT); also elsewhere on the board
SENC_INA: U4.5 (BIN); also elsewhere on the board
SENC_INA_3V3: U4.4 (BOUT); also elsewhere on the board
SENC_INB: U4.7 (CIN); also elsewhere on the board
SENC_INB_3V3: U4.6 (COUT); also elsewhere on the board

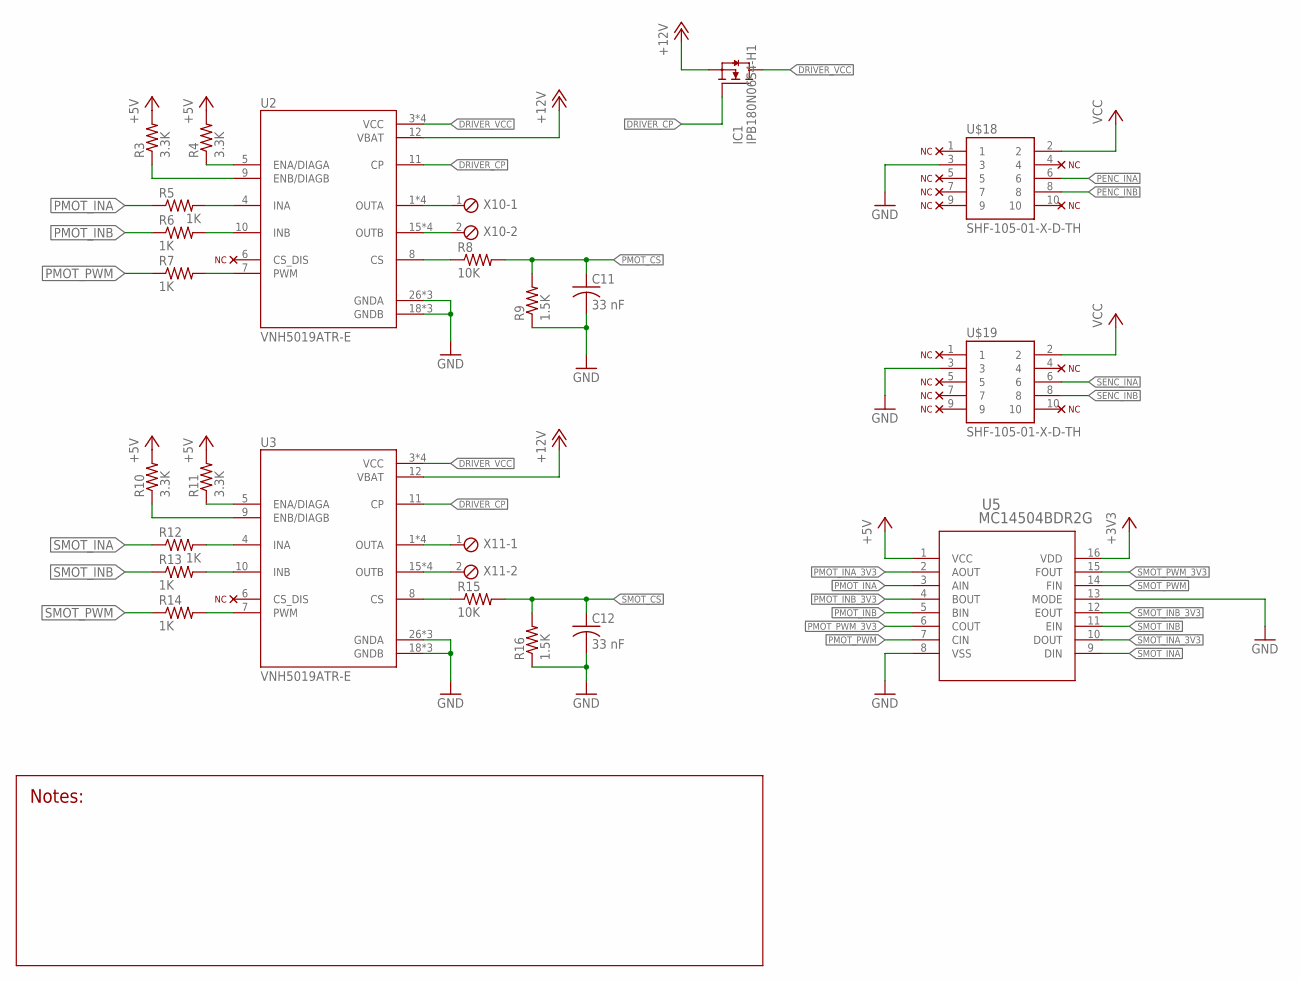
[picture p21: schematic eCVT 507.sch, sheet 3]

Parts:
C11, C12: 33 nF; C0805
IC1: IPB180N06S4-H1; PG-TO263-7-3
R3, R4, R10, R11: 3.3K; R0805
R5, R6, R7, R12, R13, R14: 1K; R0805
R8, R15: 10K; R0805
R9, R16: 1.5K; R0805
U2, U3: VNH5019ATR-E; IC_VNH5019ATR-E
U5: MC14504BDR2G; SOIC-16
U$18, U$19: SHF-105-01-X-D-TH
X10, X11: SCREWTERM_2P_381; 2POL381

Connections:
+3V3: U5.16 (VDD); also elsewhere on the board
+5V: R3.2, R4.2, R10.2, R11.2, U5.1 (VCC); also elsewhere on the board
+12V: IC1.2 (S), IC1.3 (S), IC1.5 (S), IC1.6 (S), IC1.7 (S), U2.12 (VBAT), U3.12 (VBAT); also elsewhere on the board
DRIVER_CP: IC1.1 (G), U2.11 (CP), U3.11 (CP)
DRIVER_VCC: IC1.8 (D), U2.3 (VCC), U2.13 (VCC), U2.23 (VCC), U2.HS1 (VCC), U3.3 (VCC), U3.13 (VCC), U3.23 (VCC), U3.HS1 (VCC)
GND: C11.2, C12.2, R9.1, R16.1, U2.18 (GNDB), U2.19 (GNDB), U2.20 (GNDB), U2.26 (GNDA), U2.27 (GNDA), U2.28 (GNDA), U3.18 (GNDB), U3.19 (GNDB), U3.20 (GNDB), U3.26 (GNDA), U3.27 (GNDA), U3.28 (GNDA), U5.8 (VSS), U5.13 (MODE), U$18.3, U$19.3; also elsewhere on the board
unnamed: R11.1, U3.5 (ENA/DIAGA)
unnamed: R5.2, U2.4 (INA)
unnamed: R10.1, U3.9 (ENB/DIAGB)
unnamed: R4.1, U2.5 (ENA/DIAGA)
unnamed: R6.2, U2.10 (INB)
unnamed: R8.1, U2.8 (CS)
unnamed: U2.15 (OUTB), U2.16 (OUTB), U2.21 (OUTB), U2.HS3 (OUTB), X10.2
unnamed: U2.1 (OUTA), U2.25 (OUTA), U2.30 (OUTA), U2.HS2 (OUTA), X10.1
unnamed: R3.1, U2.9 (ENB/DIAGB)
unnamed: R7.2, U2.7 (PWM)
unnamed: R12.2, U3.4 (INA)
unnamed: R13.2, U3.10 (INB)
unnamed: R14.2, U3.7 (PWM)
unnamed: R15.1, U3.8 (CS)
unnamed: U3.15 (OUTB), U3.16 (OUTB), U3.21 (OUTB), U3.HS3 (OUTB), X11.2
unnamed: U3.1 (OUTA), U3.25 (OUTA), U3.30 (OUTA), U3.HS2 (OUTA), X11.1
PENC_INA: U$18.6; also elsewhere on the board
PENC_INB: U$18.8; also elsewhere on the board
PMOT_CS: C11.1, R8.2, R9.2; also elsewhere on the board
PMOT_INA: R5.1, U5.3 (AIN)
PMOT_INA_3V3: U5.2 (AOUT); also elsewhere on the board
PMOT_INB: R6.1, U5.5 (BIN)
PMOT_INB_3V3: U5.4 (BOUT); also elsewhere on the board
PMOT_PWM: R7.1, U5.7 (CIN)
PMOT_PWM_3V3: U5.6 (COUT); also elsewhere on the board
SENC_INA: U$19.6; also elsewhere on the board
SENC_INB: U$19.8; also elsewhere on the board
SMOT_CS: C12.1, R15.2, R16.2; also elsewhere on the board
SMOT_INA: R12.1, U5.9 (DIN)
SMOT_INA_3V3: U5.10 (DOUT); also elsewhere on the board
SMOT_INB: R13.1, U5.11 (EIN)
SMOT_INB_3V3: U5.12 (EOUT); also elsewhere on the board
SMOT_PWM: R14.1, U5.14 (FIN)
SMOT_PWM_3V3: U5.15 (FOUT); also elsewhere on the board
VCC: U$18.2, U$19.2; also elsewhere on the board
