DominicChm/eCVT/..Miscellaneous/Hardware/ME 507/EAGLE/projects/eCVT 507/eCVT 507.brd

## EAGLE design ..Miscellaneous/Hardware/ME 507/EAGLE/projects/eCVT 507/eCVT 507.brd (continued)

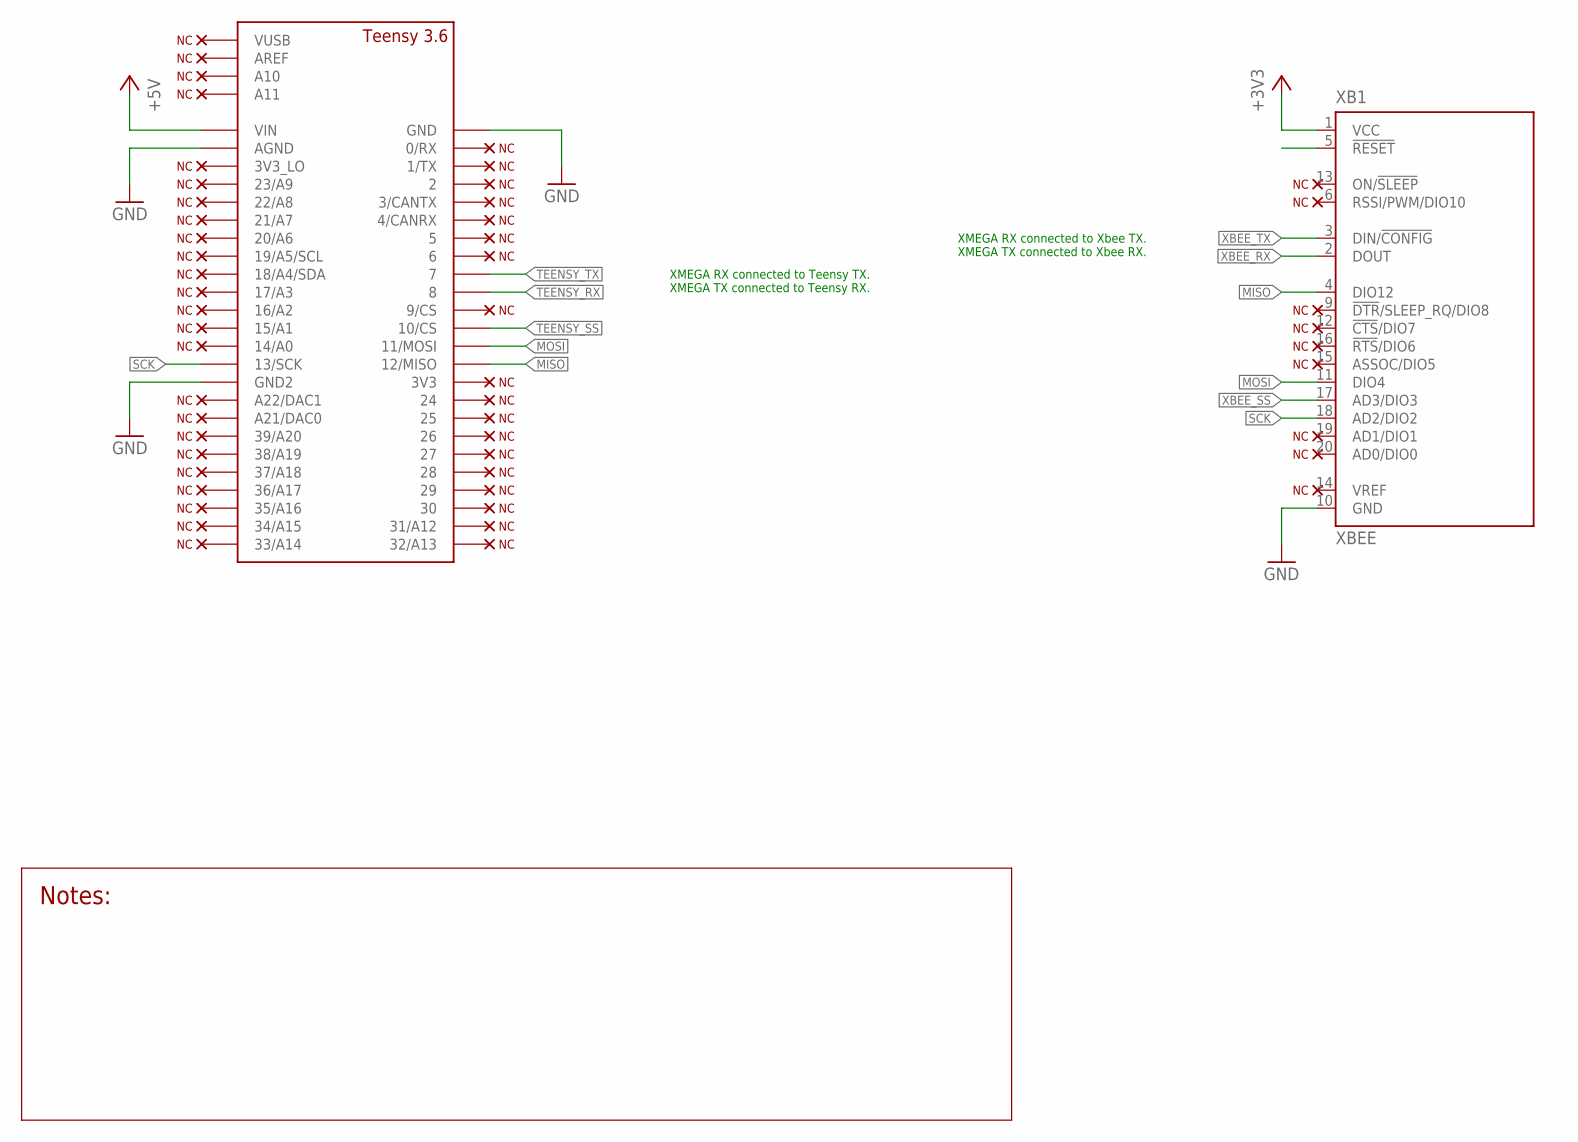
[picture p22: schematic eCVT 507.sch, sheet 4]

Parts:
U$3: TEENSY_3.5/3.6_BASIC
XB1: XBEE

Connections:
+3V3: XB1.1 (VCC); also elsewhere on the board
+5V: U$3.VIN; also elsewhere on the board
GND: U$3.AGND, U$3.GND, U$3.GND2, XB1.10 (GND); also elsewhere on the board
MISO: U$3.12/MISO, XB1.4 (DIO12); also elsewhere on the board
MOSI: U$3.11/MOSI, XB1.11 (DIO4); also elsewhere on the board
SCK: U$3.13/SCK, XB1.18 (AD2/DIO2); also elsewhere on the board
TEENSY_RX: U$3.8; also elsewhere on the board
TEENSY_SS: U$3.10/CS; also elsewhere on the board
TEENSY_TX: U$3.7; also elsewhere on the board
XBEE_RX: XB1.2 (DOUT); also elsewhere on the board
XBEE_SS: XB1.17 (AD3/DIO3); also elsewhere on the board
XBEE_TX: XB1.3 (DIN/!CONFIG); also elsewhere on the board

Notes on the sheet:
XMEGA RX connected to Xbee TX. XMEGA TX connected to Xbee RX.
XMEGA RX connected to Teensy TX. XMEGA TX connected to Teensy RX.

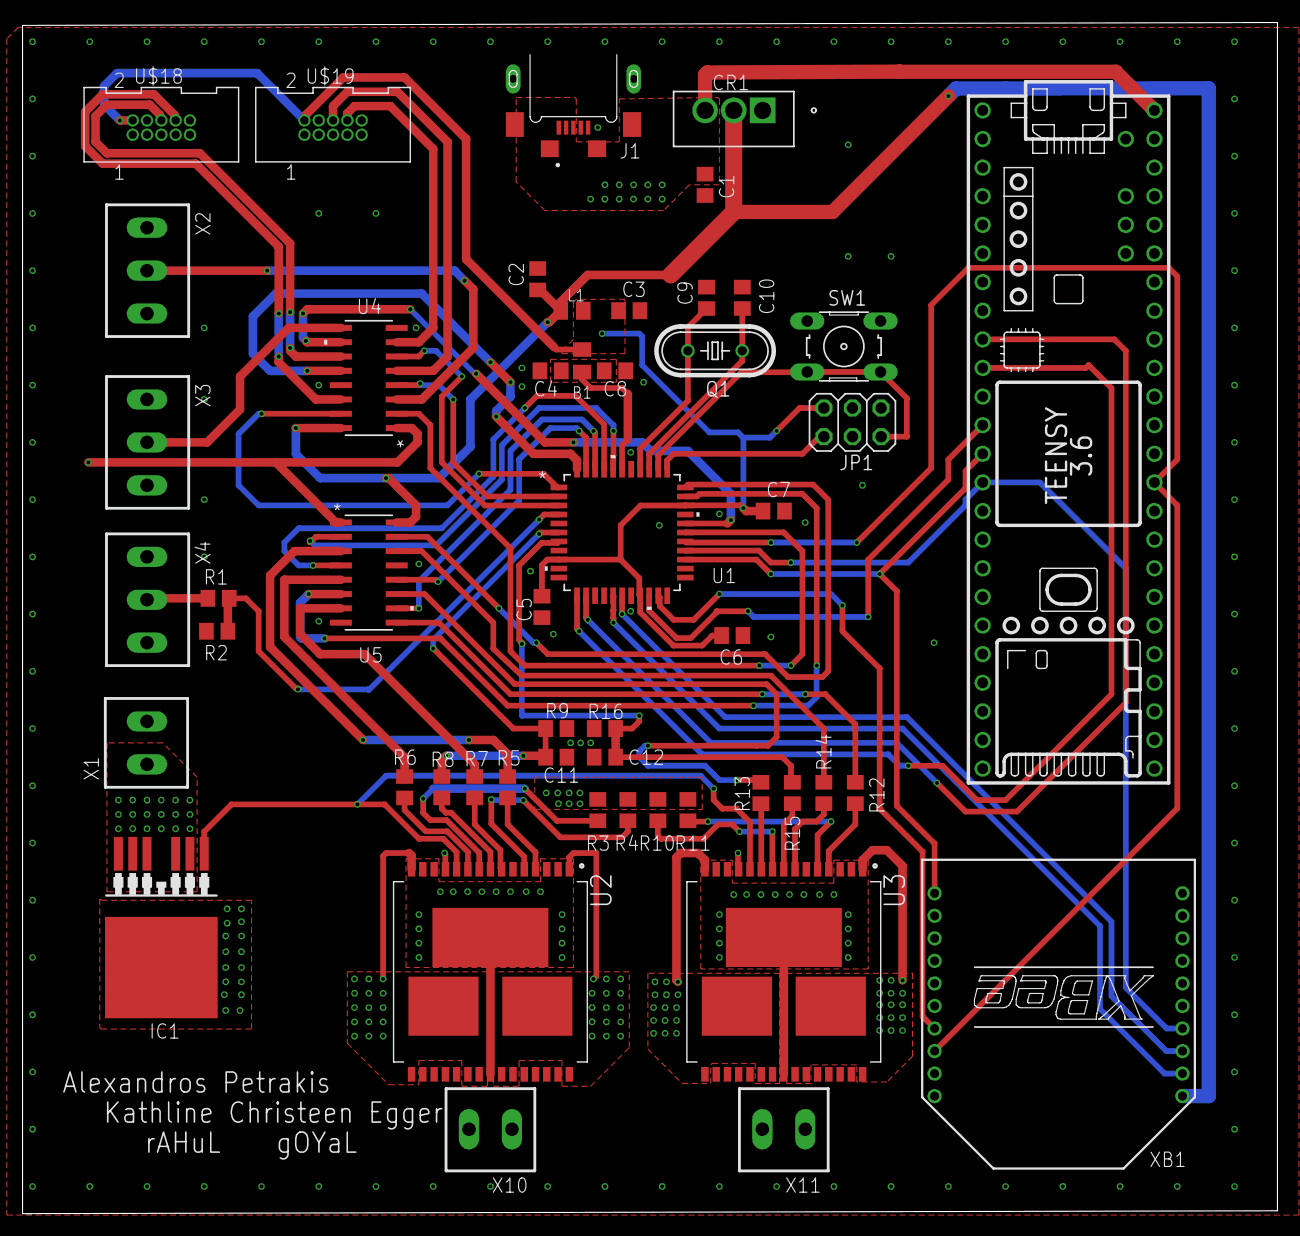
[picture p23: board eCVT 507.brd from above]

Board: 2 copper layers, 111.4 x 105.7 mm, 51 parts (0 on the bottom side), 65 nets.
