DominicChm/eCVT/..Miscellaneous/Hardware/December 2019 Edition/EAGLE/projects/DAQ and eCVT/DAQ and eCVT.brd

## EAGLE design ..Miscellaneous/Hardware/December 2019 Edition/EAGLE/projects/DAQ and eCVT/DAQ and eCVT.brd (2020-02-21)

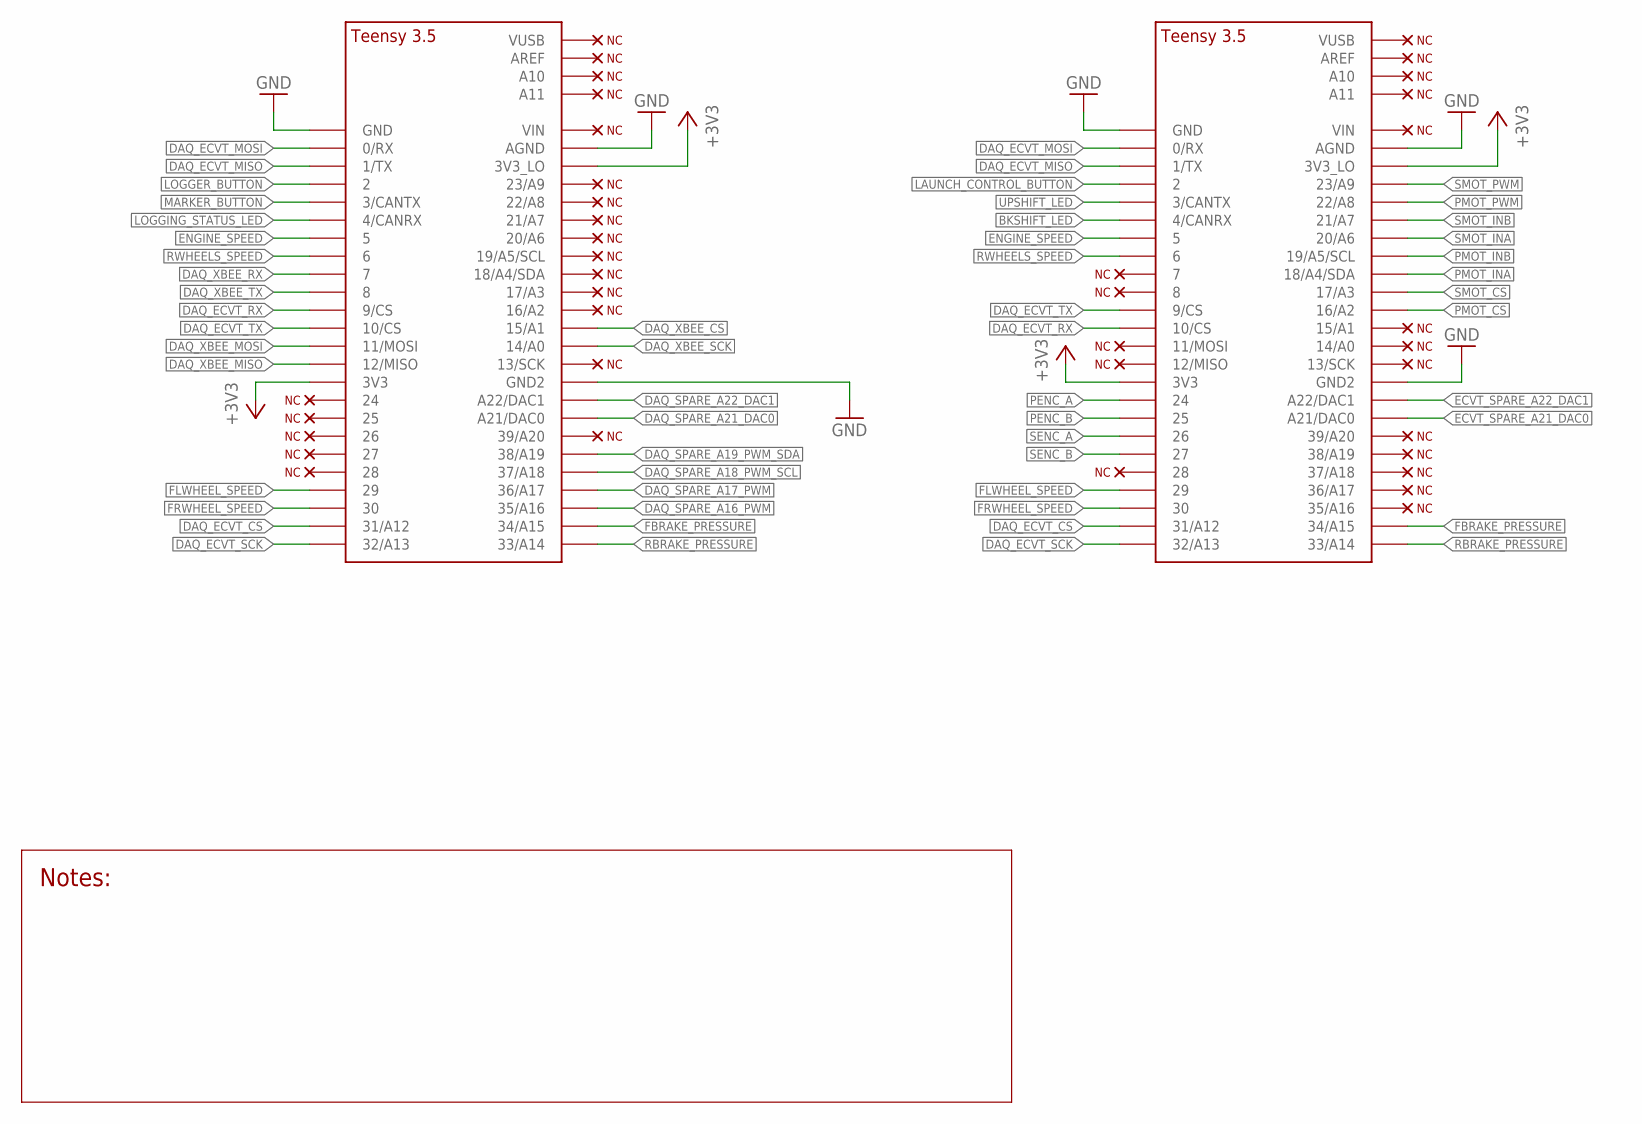
[picture p24: schematic DAQ and eCVT.sch, sheet 1]

Parts:
DAQ: TEENSY_3.5
ECVT: TEENSY_3.5

Connections:
+3V3: DAQ.3V3, DAQ.3V3_LO, ECVT.3V3, ECVT.3V3_LO; also elsewhere on the board
BKSHIFT_LED: ECVT.4/CANRX; also elsewhere on the board
DAQ_ECVT_CS: DAQ.31/A12, ECVT.31/A12
DAQ_ECVT_MISO: DAQ.1/TX, ECVT.1/TX
DAQ_ECVT_MOSI: DAQ.0/RX, ECVT.0/RX
DAQ_ECVT_RX: DAQ.9/CS, ECVT.10/CS
DAQ_ECVT_SCK: DAQ.32/A13, ECVT.32/A13
DAQ_ECVT_TX: DAQ.10/CS, ECVT.9/CS
DAQ_SPARE_A16_PWM: DAQ.35/A16; also elsewhere on the board
DAQ_SPARE_A17_PWM: DAQ.36/A17; also elsewhere on the board
DAQ_SPARE_A18_PWM_SCL: DAQ.37/A18; also elsewhere on the board
DAQ_SPARE_A19_PWM_SDA: DAQ.38/A19; also elsewhere on the board
DAQ_SPARE_A21_DAC0: DAQ.21/DAC0 (A21/DAC0); also elsewhere on the board
DAQ_SPARE_A22_DAC1: DAQ.A22/DAC1; also elsewhere on the board
DAQ_XBEE_CS: DAQ.15/A1; also elsewhere on the board
DAQ_XBEE_MISO: DAQ.12/MISO; also elsewhere on the board
DAQ_XBEE_MOSI: DAQ.11/MOSI; also elsewhere on the board
DAQ_XBEE_RX: DAQ.7; also elsewhere on the board
DAQ_XBEE_SCK: DAQ.14/A0; also elsewhere on the board
DAQ_XBEE_TX: DAQ.8; also elsewhere on the board
ECVT_SPARE_A21_DAC0: ECVT.21/DAC0 (A21/DAC0); also elsewhere on the board
ECVT_SPARE_A22_DAC1: ECVT.A22/DAC1; also elsewhere on the board
ENGINE_SPEED: DAQ.5, ECVT.5; also elsewhere on the board
FBRAKE_PRESSURE: DAQ.34/A15, ECVT.34/A15; also elsewhere on the board
FLWHEEL_SPEED: DAQ.29, ECVT.29; also elsewhere on the board
FRWHEEL_SPEED: DAQ.30, ECVT.30; also elsewhere on the board
GND: DAQ.AGND, DAQ.GND, DAQ.GND2, ECVT.AGND, ECVT.GND, ECVT.GND2; also elsewhere on the board
LAUNCH_CONTROL_BUTTON: ECVT.2; also elsewhere on the board
LOGGER_BUTTON: DAQ.2; also elsewhere on the board
LOGGING_STATUS_LED: DAQ.4/CANRX; also elsewhere on the board
MARKER_BUTTON: DAQ.3/CANTX; also elsewhere on the board
PENC_A: ECVT.24; also elsewhere on the board
PENC_B: ECVT.25; also elsewhere on the board
PMOT_CS: ECVT.16/A2; also elsewhere on the board
PMOT_INA: ECVT.18/A4/SDA; also elsewhere on the board
PMOT_INB: ECVT.19/A5/SCL; also elsewhere on the board
PMOT_PWM: ECVT.22/A8; also elsewhere on the board
RBRAKE_PRESSURE: DAQ.33/A14, ECVT.33/A14; also elsewhere on the board
RWHEELS_SPEED: DAQ.6, ECVT.6; also elsewhere on the board
SENC_A: ECVT.26; also elsewhere on the board
SENC_B: ECVT.27; also elsewhere on the board
SMOT_CS: ECVT.17/A3; also elsewhere on the board
SMOT_INA: ECVT.20/A6; also elsewhere on the board
SMOT_INB: ECVT.21/A7; also elsewhere on the board
SMOT_PWM: ECVT.23/A9; also elsewhere on the board
UPSHIFT_LED: ECVT.3/CANTX; also elsewhere on the board

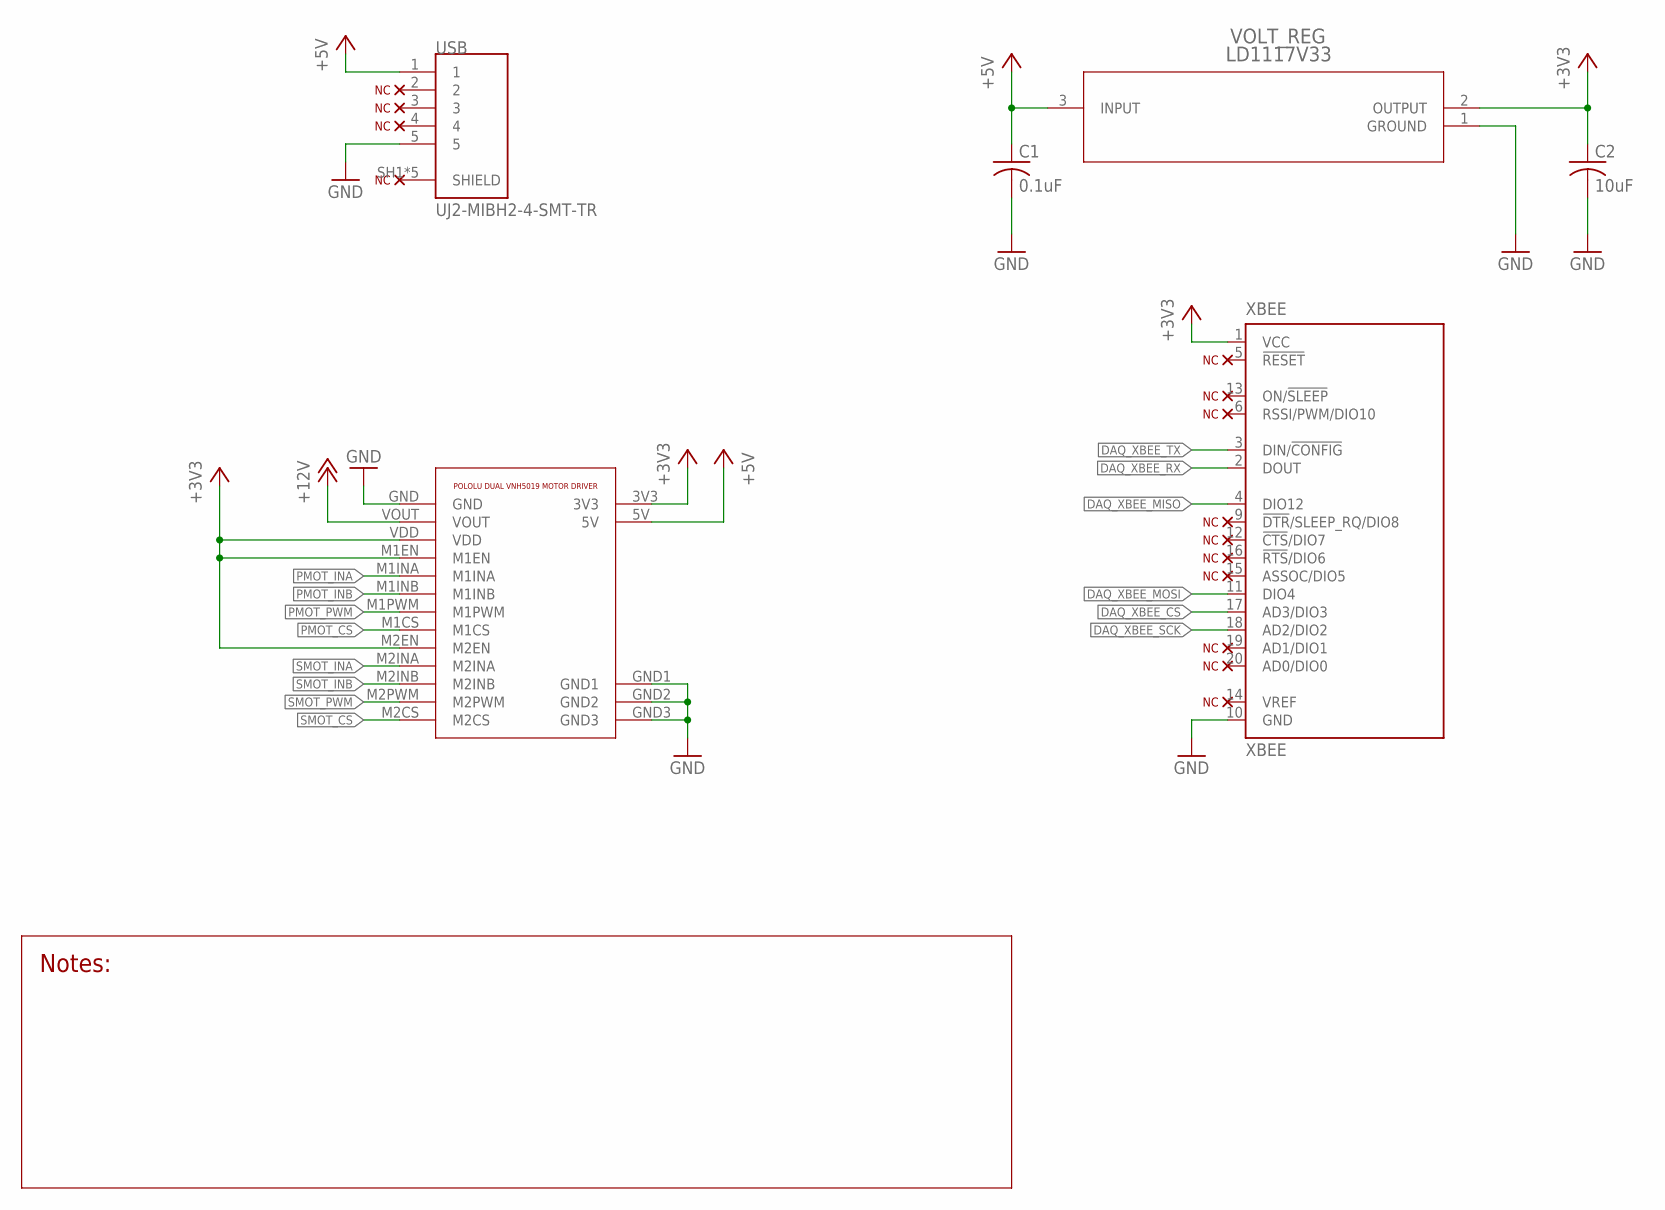
[picture p25: schematic DAQ and eCVT.sch, sheet 2]

Parts:
C1: 0.1uF; C0805
C2: 10uF; C0805
MOTOR_DRIVER: POLOLU_DUAL_VNH5019
USB: UJ2-MIBH2-4-SMT-TR; CUI_UJ2-MIBH2-4-SMT-TR
VOLT_REG: LD1117V33; TO-220
XBEE: XBEE

Connections:
+3V3: C2.1, MOTOR_DRIVER.3V3, MOTOR_DRIVER.M1EN, MOTOR_DRIVER.M2EN, MOTOR_DRIVER.VDD, VOLT_REG.2 (OUTPUT), XBEE.1 (VCC); also elsewhere on the board
+5V: C1.1, MOTOR_DRIVER.5V, USB.1, VOLT_REG.3 (INPUT); also elsewhere on the board
+12V: MOTOR_DRIVER.VOUT; also elsewhere on the board
DAQ_XBEE_CS: XBEE.17 (AD3/DIO3); also elsewhere on the board
DAQ_XBEE_MISO: XBEE.4 (DIO12); also elsewhere on the board
DAQ_XBEE_MOSI: XBEE.11 (DIO4); also elsewhere on the board
DAQ_XBEE_RX: XBEE.2 (DOUT); also elsewhere on the board
DAQ_XBEE_SCK: XBEE.18 (AD2/DIO2); also elsewhere on the board
DAQ_XBEE_TX: XBEE.3 (DIN/!CONFIG); also elsewhere on the board
GND: C1.2, C2.2, MOTOR_DRIVER.GND, MOTOR_DRIVER.GND1, MOTOR_DRIVER.GND2, MOTOR_DRIVER.GND3, USB.5, VOLT_REG.1 (GROUND), XBEE.10 (GND); also elsewhere on the board
unnamed: USB.SH1 (SHIELD), USB.SH2 (SHIELD), USB.SH3 (SHIELD), USB.SH4 (SHIELD), USB.SH5 (SHIELD)
PMOT_CS: MOTOR_DRIVER.M1CS; also elsewhere on the board
PMOT_INA: MOTOR_DRIVER.M1INA; also elsewhere on the board
PMOT_INB: MOTOR_DRIVER.M1INB; also elsewhere on the board
PMOT_PWM: MOTOR_DRIVER.M1PWM; also elsewhere on the board
SMOT_CS: MOTOR_DRIVER.M2CS; also elsewhere on the board
SMOT_INA: MOTOR_DRIVER.M2INA; also elsewhere on the board
SMOT_INB: MOTOR_DRIVER.M2INB; also elsewhere on the board
SMOT_PWM: MOTOR_DRIVER.M2PWM; also elsewhere on the board

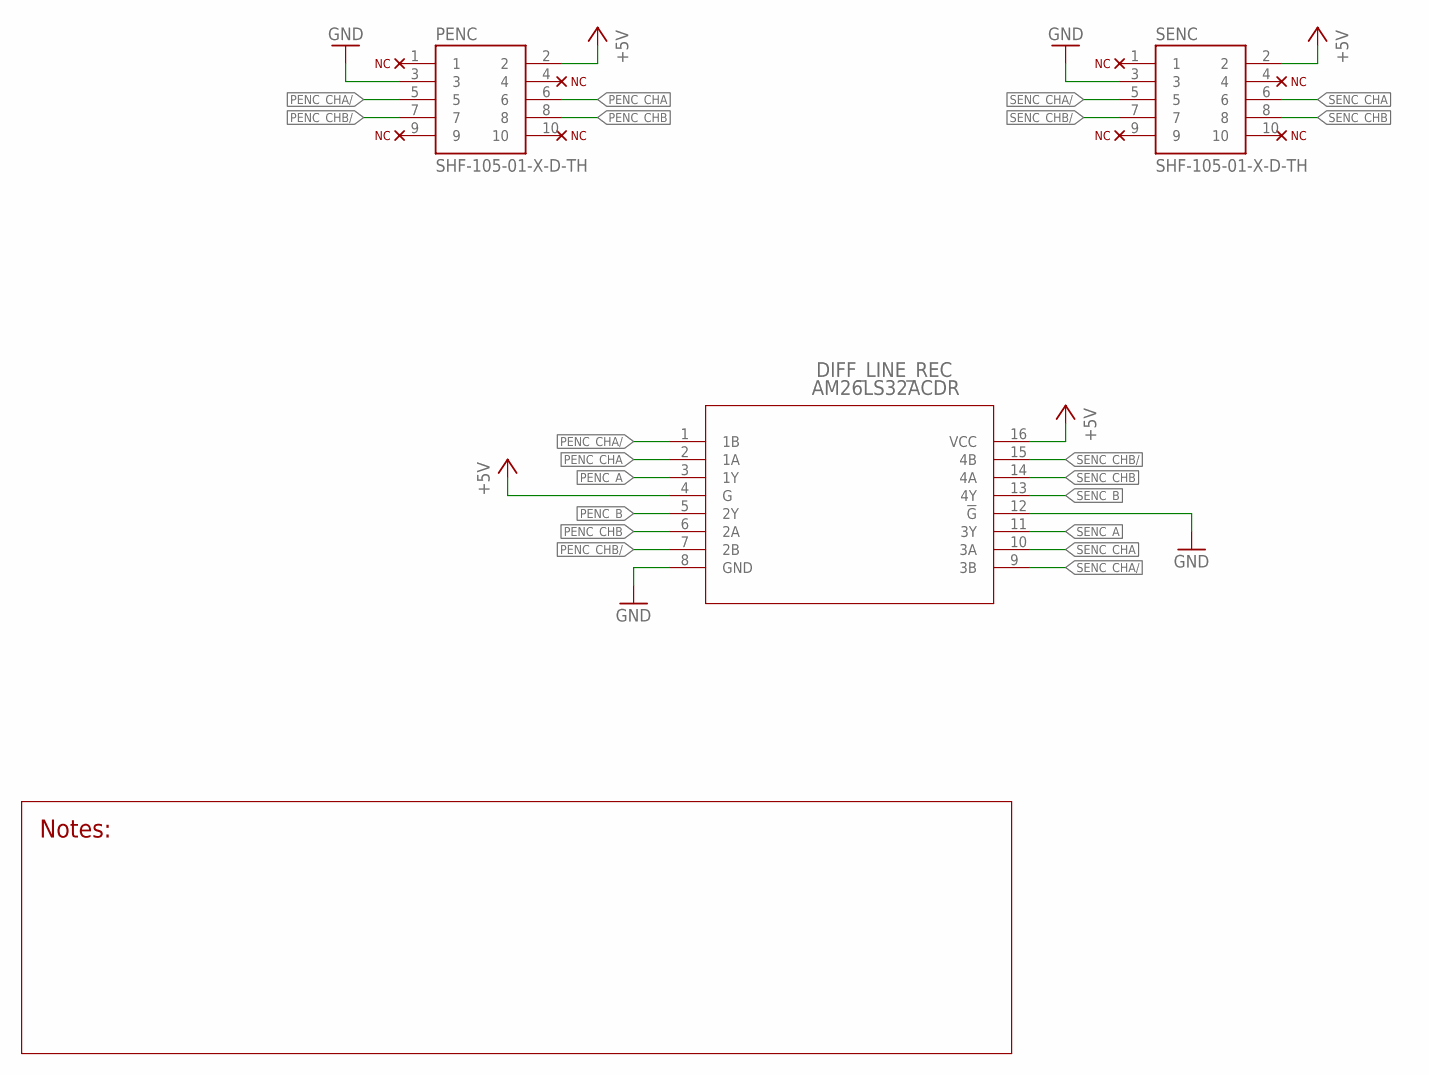
[picture p26: schematic DAQ and eCVT.sch, sheet 3]

Parts:
DIFF_LINE_REC: AM26LS32ACDR; D16
PENC: SHF-105-01-X-D-TH
SENC: SHF-105-01-X-D-TH

Connections:
+5V: DIFF_LINE_REC.4 (G), DIFF_LINE_REC.16 (VCC), PENC.2, SENC.2; also elsewhere on the board
GND: DIFF_LINE_REC.8 (GND), DIFF_LINE_REC.12 (!G), PENC.3, SENC.3; also elsewhere on the board
PENC_A: DIFF_LINE_REC.3 (1Y); also elsewhere on the board
PENC_B: DIFF_LINE_REC.5 (2Y); also elsewhere on the board
PENC_CHA: DIFF_LINE_REC.2 (1A), PENC.6
PENC_CHA/: DIFF_LINE_REC.1 (1B), PENC.5
PENC_CHB: DIFF_LINE_REC.6 (2A), PENC.8
PENC_CHB/: DIFF_LINE_REC.7 (2B), PENC.7
SENC_A: DIFF_LINE_REC.11 (3Y); also elsewhere on the board
SENC_B: DIFF_LINE_REC.13 (4Y); also elsewhere on the board
SENC_CHA: DIFF_LINE_REC.10 (3A), SENC.6
SENC_CHA/: DIFF_LINE_REC.9 (3B), SENC.5
SENC_CHB: DIFF_LINE_REC.14 (4A), SENC.8
SENC_CHB/: DIFF_LINE_REC.15 (4B), SENC.7

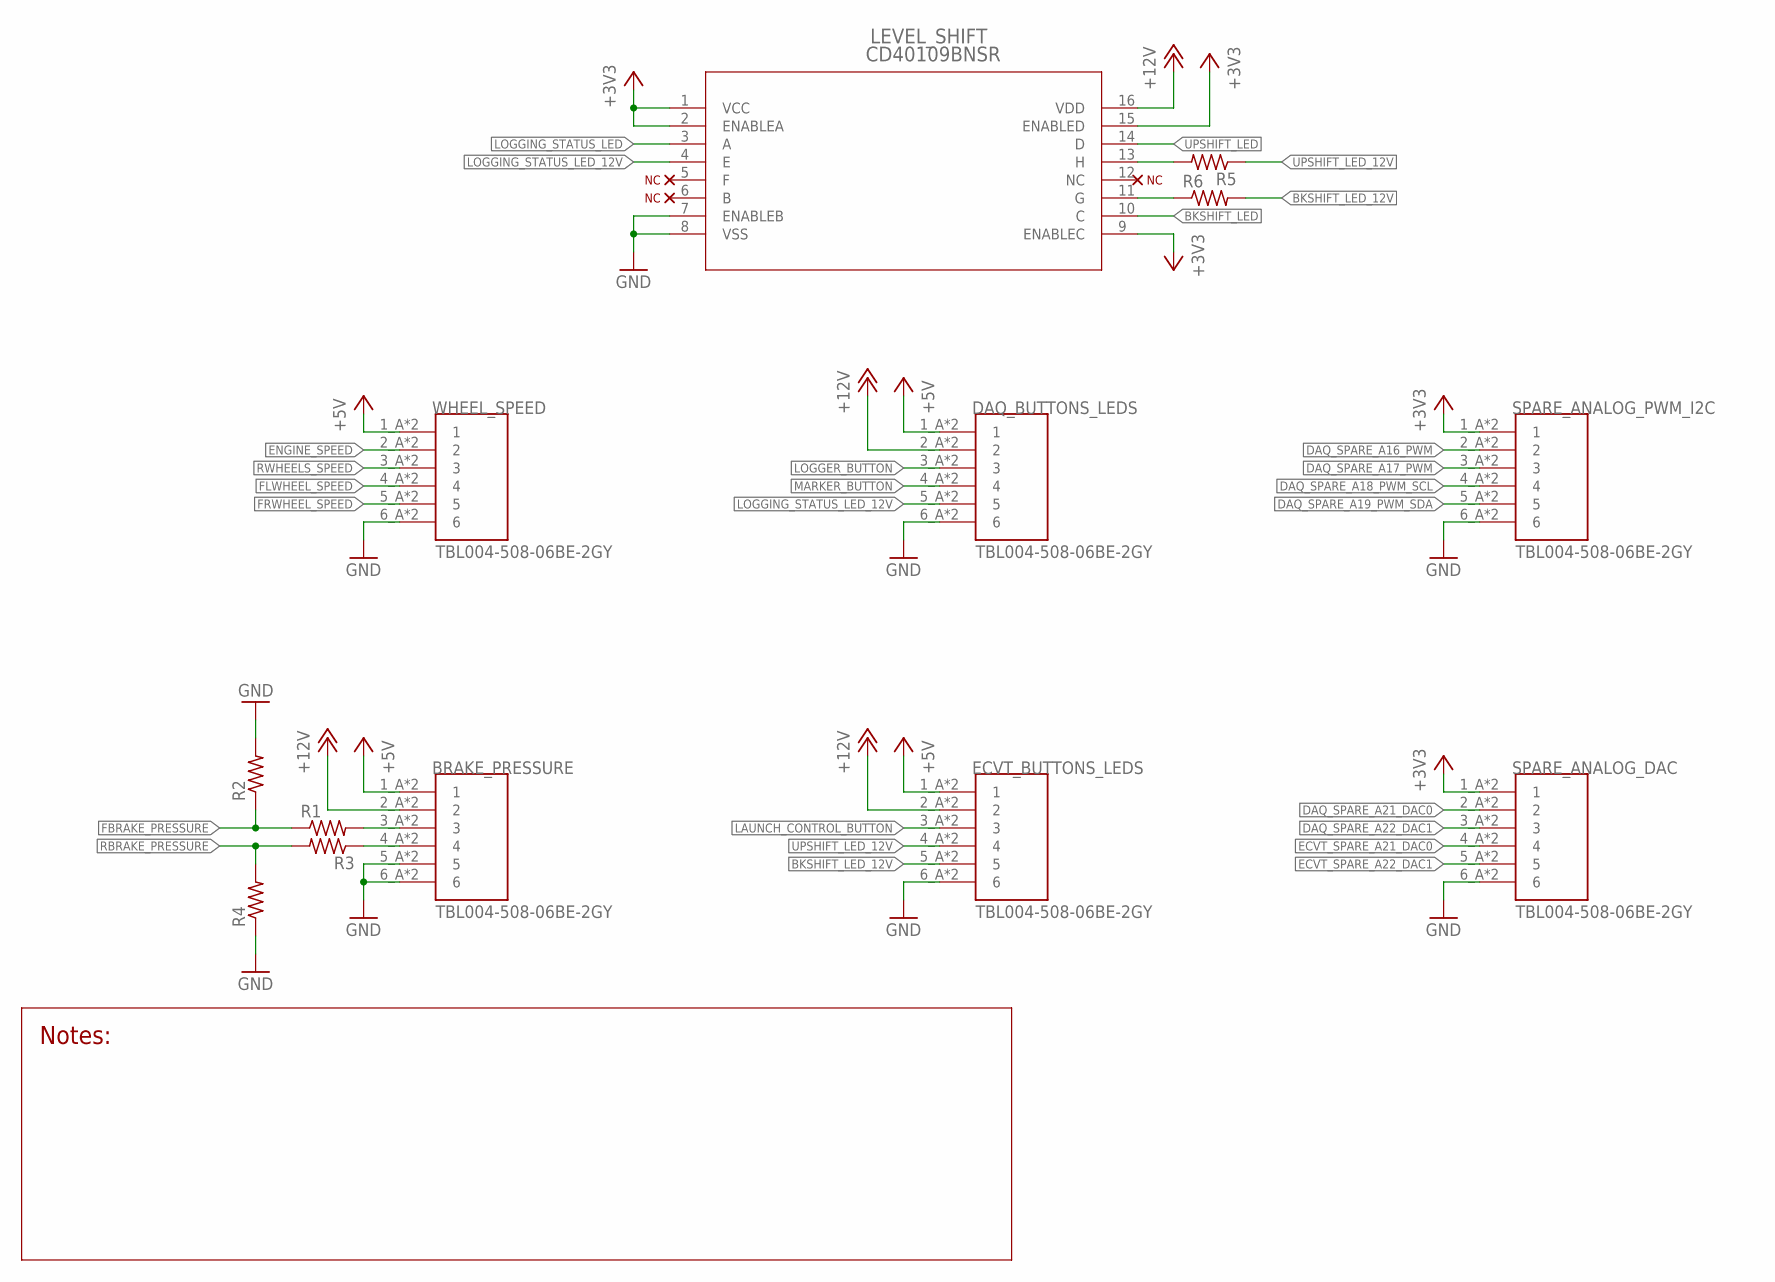
[picture p27: schematic DAQ and eCVT.sch, sheet 4]

Parts:
BRAKE_PRESSURE: TBL004-508-06BE-2GY; CUI_TBL004-508-06BE-2GY
DAQ_BUTTONS_LEDS: TBL004-508-06BE-2GY; CUI_TBL004-508-06BE-2GY
ECVT_BUTTONS_LEDS: TBL004-508-06BE-2GY; CUI_TBL004-508-06BE-2GY
LEVEL_SHIFT: CD40109BNSR; NS16
R1, R2, R3, R4, R5, R6: R-US_0204/7; 0204/7
SPARE_ANALOG_DAC: TBL004-508-06BE-2GY; CUI_TBL004-508-06BE-2GY
SPARE_ANALOG_PWM_I2C: TBL004-508-06BE-2GY; CUI_TBL004-508-06BE-2GY
WHEEL_SPEED: TBL004-508-06BE-2GY; CUI_TBL004-508-06BE-2GY

Connections:
+3V3: LEVEL_SHIFT.1 (VCC), LEVEL_SHIFT.2 (ENABLEA), LEVEL_SHIFT.9 (ENABLEC), LEVEL_SHIFT.15 (ENABLED), SPARE_ANALOG_DAC.1_A (1), SPARE_ANALOG_DAC.1_B (1), SPARE_ANALOG_PWM_I2C.1_A (1), SPARE_ANALOG_PWM_I2C.1_B (1); also elsewhere on the board
+5V: BRAKE_PRESSURE.1_A (1), BRAKE_PRESSURE.1_B (1), DAQ_BUTTONS_LEDS.1_A (1), DAQ_BUTTONS_LEDS.1_B (1), ECVT_BUTTONS_LEDS.1_A (1), ECVT_BUTTONS_LEDS.1_B (1), WHEEL_SPEED.1_A (1), WHEEL_SPEED.1_B (1); also elsewhere on the board
+12V: BRAKE_PRESSURE.2_A (2), BRAKE_PRESSURE.2_B (2), DAQ_BUTTONS_LEDS.2_A (2), DAQ_BUTTONS_LEDS.2_B (2), ECVT_BUTTONS_LEDS.2_A (2), ECVT_BUTTONS_LEDS.2_B (2), LEVEL_SHIFT.16 (VDD); also elsewhere on the board
BACKSHIFT_LED_12V_W/O_RES: LEVEL_SHIFT.11 (G), R6.1
BKSHIFT_LED: LEVEL_SHIFT.10 (C); also elsewhere on the board
BKSHIFT_LED_12V: ECVT_BUTTONS_LEDS.5_A (5), ECVT_BUTTONS_LEDS.5_B (5), R6.2
DAQ_SPARE_A16_PWM: SPARE_ANALOG_PWM_I2C.2_A (2), SPARE_ANALOG_PWM_I2C.2_B (2); also elsewhere on the board
DAQ_SPARE_A17_PWM: SPARE_ANALOG_PWM_I2C.3_A (3), SPARE_ANALOG_PWM_I2C.3_B (3); also elsewhere on the board
DAQ_SPARE_A18_PWM_SCL: SPARE_ANALOG_PWM_I2C.4_A (4), SPARE_ANALOG_PWM_I2C.4_B (4); also elsewhere on the board
DAQ_SPARE_A19_PWM_SDA: SPARE_ANALOG_PWM_I2C.5_A (5), SPARE_ANALOG_PWM_I2C.5_B (5); also elsewhere on the board
DAQ_SPARE_A21_DAC0: SPARE_ANALOG_DAC.2_A (2), SPARE_ANALOG_DAC.2_B (2); also elsewhere on the board
DAQ_SPARE_A22_DAC1: SPARE_ANALOG_DAC.3_A (3), SPARE_ANALOG_DAC.3_B (3); also elsewhere on the board
ECVT_SPARE_A21_DAC0: SPARE_ANALOG_DAC.4_A (4), SPARE_ANALOG_DAC.4_B (4); also elsewhere on the board
ECVT_SPARE_A22_DAC1: SPARE_ANALOG_DAC.5_A (5), SPARE_ANALOG_DAC.5_B (5); also elsewhere on the board
ENGINE_SPEED: WHEEL_SPEED.2_A (2), WHEEL_SPEED.2_B (2); also elsewhere on the board
FBRAKE_PRESSURE: R1.1, R2.1; also elsewhere on the board
FBRAKE_PRESSURE_W/O_RES: BRAKE_PRESSURE.3_A (3), BRAKE_PRESSURE.3_B (3), R1.2
FLWHEEL_SPEED: WHEEL_SPEED.4_A (4), WHEEL_SPEED.4_B (4); also elsewhere on the board
FRWHEEL_SPEED: WHEEL_SPEED.5_A (5), WHEEL_SPEED.5_B (5); also elsewhere on the board
GND: BRAKE_PRESSURE.5_A (5), BRAKE_PRESSURE.5_B (5), BRAKE_PRESSURE.6_A (6), BRAKE_PRESSURE.6_B (6), DAQ_BUTTONS_LEDS.6_A (6), DAQ_BUTTONS_LEDS.6_B (6), ECVT_BUTTONS_LEDS.6_A (6), ECVT_BUTTONS_LEDS.6_B (6), LEVEL_SHIFT.7 (ENABLEB), LEVEL_SHIFT.8 (VSS), R2.2, R4.1, SPARE_ANALOG_DAC.6_A (6), SPARE_ANALOG_DAC.6_B (6), SPARE_ANALOG_PWM_I2C.6_A (6), SPARE_ANALOG_PWM_I2C.6_B (6), WHEEL_SPEED.6_A (6), WHEEL_SPEED.6_B (6); also elsewhere on the board
LAUNCH_CONTROL_BUTTON: ECVT_BUTTONS_LEDS.3_A (3), ECVT_BUTTONS_LEDS.3_B (3); also elsewhere on the board
LOGGER_BUTTON: DAQ_BUTTONS_LEDS.3_A (3), DAQ_BUTTONS_LEDS.3_B (3); also elsewhere on the board
LOGGING_STATUS_LED: LEVEL_SHIFT.3 (A); also elsewhere on the board
LOGGING_STATUS_LED_12V: DAQ_BUTTONS_LEDS.5_A (5), DAQ_BUTTONS_LEDS.5_B (5), LEVEL_SHIFT.4 (E)
MARKER_BUTTON: DAQ_BUTTONS_LEDS.4_A (4), DAQ_BUTTONS_LEDS.4_B (4); also elsewhere on the board
RBRAKE_PRESSURE: R3.2, R4.2; also elsewhere on the board
RBRAKE_PRESSURE_W/O_RES: BRAKE_PRESSURE.4_A (4), BRAKE_PRESSURE.4_B (4), R3.1
RWHEELS_SPEED: WHEEL_SPEED.3_A (3), WHEEL_SPEED.3_B (3); also elsewhere on the board
UPSHIFT_LED: LEVEL_SHIFT.14 (D); also elsewhere on the board
UPSHIFT_LED_12V: ECVT_BUTTONS_LEDS.4_A (4), ECVT_BUTTONS_LEDS.4_B (4), R5.1
UPSHIFT_LED_12V_W/O_RES: LEVEL_SHIFT.13 (H), R5.2

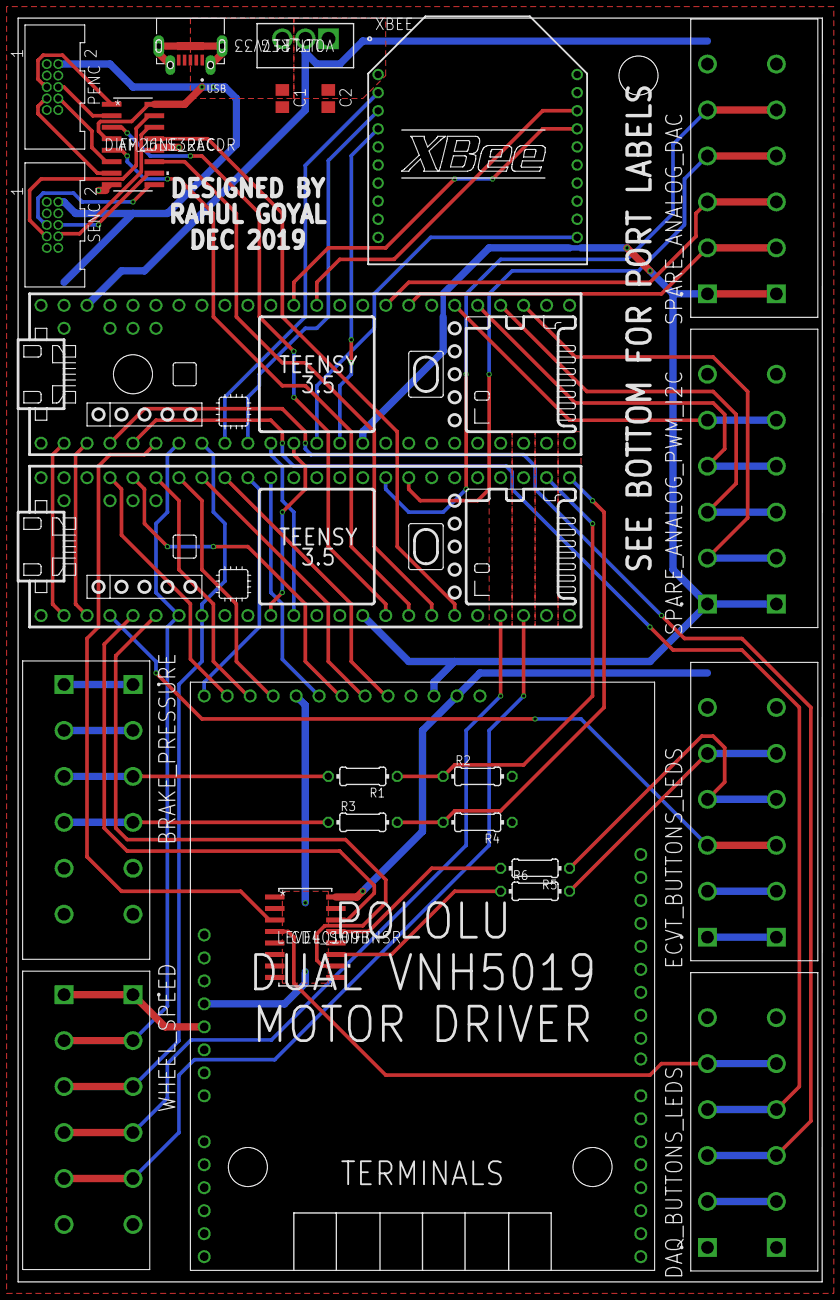
[picture p28: board ..Miscellaneous/Hardware/December 2019 Edition/EAGLE/projects/DAQ and… from above]

Board: 2 copper layers, 88.9 x 139.7 mm, 24 parts (0 on the bottom side), 64 nets.
