DominicChm/eCVT/include/WiringDec2019.h

/*
 *  WiringDec2019.h - DAQ and eCVT wiring configuration.
 *  Created by Rahul Goyal, December 2019.
 *  Released to Cal Poly Baja SAE. ;)
 */

#ifndef WiringDec2019_h
#define WiringDec2019_h

#include <Arduino.h>

// Hall Effect Sensors
const int8_t  ENGINE_SPEED_PIN =  5;
const int8_t RWHEELS_SPEED_PIN =  6;
const int8_t FLWHEEL_SPEED_PIN = 29;
const int8_t FRWHEEL_SPEED_PIN = 30;

// Encoders
/* Swap A and B pins to swap direction. */
const int8_t P_ENC_A = 24;
const int8_t P_ENC_B = 25;
const int8_t S_ENC_A = 27;
const int8_t S_ENC_B = 26;

// Motors
/* Swap A and B pins to swap direction. */
const int8_t P_MOT_INA = 19;
const int8_t P_MOT_INB = 18;
const int8_t P_MOT_PWM = 22;
const int8_t S_MOT_INA = 20;
const int8_t S_MOT_INB = 21;
const int8_t S_MOT_PWM = 23;

// Pressure Transducers
const int8_t FBRAKE_PRESSURE = 34;
const int8_t RBRAKE_PRESSURE = 33;

// Dashboard
const int8_t LOGGER_BUTTON = 2;
const int8_t MARKER_BUTTON = 3;
const int8_t LAUNCH_BUTTON = 2;
const int8_t  DAQ_STATUS_LED = 4;
const int8_t ECVT_STATUS_LED = 0;
const int8_t UPSHIFT_LED = 3;
const int8_t BKSHIFT_LED = 4;

// Communication
#define DAQ_ECVT_SERIAL Serial1
#define DAQ_XBEE_SERIAL Serial2

#endif
