DominicChm/eCVT/include/LookupTables.h

/*
 *  LookupTables.h - Lookup table arrays.
 *  Created by Rahul Goyal, December 2019.
 *  Released to Cal Poly Baja SAE. ;)
 */

#ifndef LookupTables_h
#define LookupTables_h

#include <Arduino.h>

// 1% Ratio Increments
static const int32_t pLookup[] = {
    64546, 63144, 61773, 60433, 59124, 57845, 56597, 55378, 54187, 53026, 51892, 50786,
    49706, 48653, 47625, 46622, 45644, 44689, 43757, 42847, 41959, 41093, 40247, 39421,
    38614, 37827, 37057, 36306, 35572, 34854, 34153, 33468, 32798, 32143, 31503, 30877,
    30264, 29665, 29078, 28504, 27942, 27393, 26854, 26327, 25810, 25304, 24809, 24323,
    23847, 23380, 22923, 22474, 22035, 21603, 21180, 20765, 20358, 19958, 19565, 19180,
    18802, 18430, 18066, 17707, 17355, 17010, 16670, 16336, 16008, 15685, 15368, 15056,
    14749, 14448, 14151, 13859, 13572, 13290, 13012, 12738, 12469, 12203, 11942, 11685,
    11432, 11183, 10937, 10696, 10457, 10223, 9991, 9763, 9539, 9317, 9099, 8884, 8672,
    8463, 8256, 8053, 7852};

// 1% Ratio Increments
static const int32_t sLookup[] = {
    0, 1549, 3036, 4463, 5834, 7150, 8415, 9631, 10800, 11924, 13006, 14047, 15050, 16015,
    16945, 17842, 18707, 19541, 20346, 21123, 21874, 22599, 23301, 23978, 24634, 25269,
    25883, 26478, 27054, 27613, 28154, 28679, 29188, 29683, 30163, 30629, 31082, 31522,
    31949, 32365, 32770, 33164, 33547, 33920, 34283, 34637, 34982, 35318, 35646, 35965,
    36277, 36581, 36878, 37168, 37451, 37727, 37997, 38261, 38519, 38771, 39018, 39259,
    39495, 39725, 39951, 40172, 40389, 40601, 40808, 41012, 41211, 41406, 41598, 41785,
    41969, 42150, 42327, 42500, 42671, 42838, 43002, 43163, 43321, 43477, 43629, 43779,
    43926, 44071, 44213, 44353, 44490, 44625, 44758, 44888, 45017, 45143, 45267, 45389,
    45509, 45628, 45744};

#endif
