DominicChm/eCVT/(commit log)

2019-06-03 Made PID and bang bang with actuator
2019-06-03 Added PID pictures and lookup table
2019-11-04 Uploaded board design for 507
    [eCVT 507.sch]
2019-11-04 Added level shifters, xbee, other fixes
    [eCVT 507.sch]
2019-11-07 Updated wiring schematic
    [eCVT 507 rev0.brd, eCVT 507.sch]
2019-12-08 Started December 2019 board
    [DAQ and eCVT.sch, eCVT 507 rev0.brd, eCVT 507.sch]
2019-12-09 Update eCVT 507 and reorganize
    [eCVT 507 rev0.brd, eCVT 507.brd, eCVT 507.csv, eCVT 507.sch]
2019-12-09 Finished schematic? (except LED wiring)
    [DAQ and eCVT.sch]
2019-12-09 Finished schematic!
    [DAQ and eCVT.sch]
2019-12-10 Started board
    [DAQ and eCVT.brd, DAQ and eCVT.sch]
2019-12-12 Finished board layout, need to add mounting holes and writing
    [DAQ and eCVT.brd, DAQ and eCVT.sch]
2019-12-12 December 2019 board finished
    [DAQ and eCVT.brd, DAQ and eCVT.sch]
2020-01-17 Friday bench testing with engine runnning no belt
2020-01-19 Minor formatting update
    [DAQ and eCVT.sch]
2020-01-21 Untested code organization, documentation, new FSMs setup, interrupt protection
2020-01-21 Move debugging statements for consistent serial monitor printout
2020-01-21 Untested additional pin configurations and commenting
2020-01-21 Untested launch control and dashboard LEDs functionality
2020-02-03 First implementation of DAQ code (slow, ~50Hz, will improve drastically)
2020-02-21 Rewired Teensys for February edition, pending full rewire
    [DAQ and eCVT.brd, DAQ and eCVT.sch]
2020-02-21 Fixed the spelling of February
    [DAQ and eCVT.brd, DAQ and eCVT.sch]
2020-02-21 Finished schematic except RJ45 connectors and LEDs, need to redo board
    [DAQ and eCVT.brd, DAQ and eCVT.sch]
2020-02-22 Finished schematic, need to check LED wiring
    [DAQ and eCVT.brd, DAQ and eCVT.sch]
2020-02-22 Rename old board file
    [DAQ and eCVT OLD.brd]
2020-02-25 Wiring the board...
    [DAQ and eCVT.brd]
2020-02-28 Thursday bench testing with engine running and belt
2020-03-02 Untested config generalization, calibration ready, hall effect sensor task, launch button fix
2020-03-02 It is now March
    [DAQ and eCVT.brd, DAQ and eCVT.sch]
2020-03-06 Untested calibration changes
2020-03-06 Thursday bench testing with improved secondary calibration, need to improve primary calibration
2020-03-09 Checkpoint before rewiring spring terminals to front/back instead of wheelspeed/brakepressure
    [DAQ and eCVT.brd]
2020-03-09 Almost done wiring the board!
    [DAQ and eCVT.brd, DAQ and eCVT.sch]
2020-03-09 No DRC errors! Need to do a final check + board writing
    [DAQ and eCVT.brd, DAQ and eCVT.sch]
2020-03-10 Small board revisions before sending out
    [DAQ and eCVT.brd, DAQ and eCVT.sch]
2020-03-10 Ready to send out
    [DAQ and eCVT.brd, DAQ and eCVT.sch]
2020-03-29 Restore motor library reference
2020-08-10 Migrate to Platform IO
    [DAQ and eCVT.brd, DAQ and eCVT.sch, eCVT 507 rev0.brd, eCVT 507.brd, eCVT 507.csv, eCVT 507.sch]
2020-08-10 Move files into correct folders (include, libraries, main)
    [WiringDec2019.h, main.cpp]
2020-08-24 Rename miscellaneous folder
    [DAQ and eCVT.brd, DAQ and eCVT.sch, eCVT 507 rev0.brd, eCVT 507.brd, eCVT 507.csv, eCVT 507.sch]
2020-08-30 Start interrupts after rear wheel speed read
2020-08-30 Fix secondary static duty cycle condition
    [main.cpp]
2021-01-07 Remove need to include wiring info in LaunchControl
2021-01-07 Create Sensor class
2021-01-14 Update EngineSpeed and WheelSpeed
2021-01-17 Remove FSMVars from sensors
2021-01-21 Fix comment spacing in Clutch.cpp
    [Clutch.cpp]
2021-01-21 Fix indent and move FSMVars to src
    [Clutch.cpp, Clutch.h]
2021-01-28 Move timers to main
2021-02-15 Fix lookup table indentation
    [LookupTables.h]
2021-02-18 Fix if statement spacing
    [Clutch.cpp, DashboardLEDs.cpp, LaunchControl.cpp]
